AJC938/AI-PCB-Engineer/hardware/sandbox/README.md

# Sandbox

Throwaway KiCad projects used to test MCP tools and automation. Nothing here is a
deliverable, and the contents (other than this file) are gitignored. Never copy a
real design here for experiments — copy sandbox results into `hardware/kicad/`
only after review.
