AJC938/AI-PCB-Engineer/docs/visual-review/VISUAL_REVIEW.md

# Visual Review — Rev A

The generated renders below were produced from the Rev A design files using KiCad 10.0.8 command-line exports. The separate `images/screenshots/` gallery contains seven **actual GUI screenshots** captured from the released project in KiCad Schematic Editor, PCB Editor, and 3D Viewer.

No photograph exists because no board has been manufactured. 3D component bodies are KiCad library models and **represent shape only, not the exact purchased parts**. For example, LED2 is green in the BOM but uses the generic red LED model.

## Actual KiCad GUI screenshots

| Schematic | Power | PCB top | PCB bottom |
|---|---|---|---|
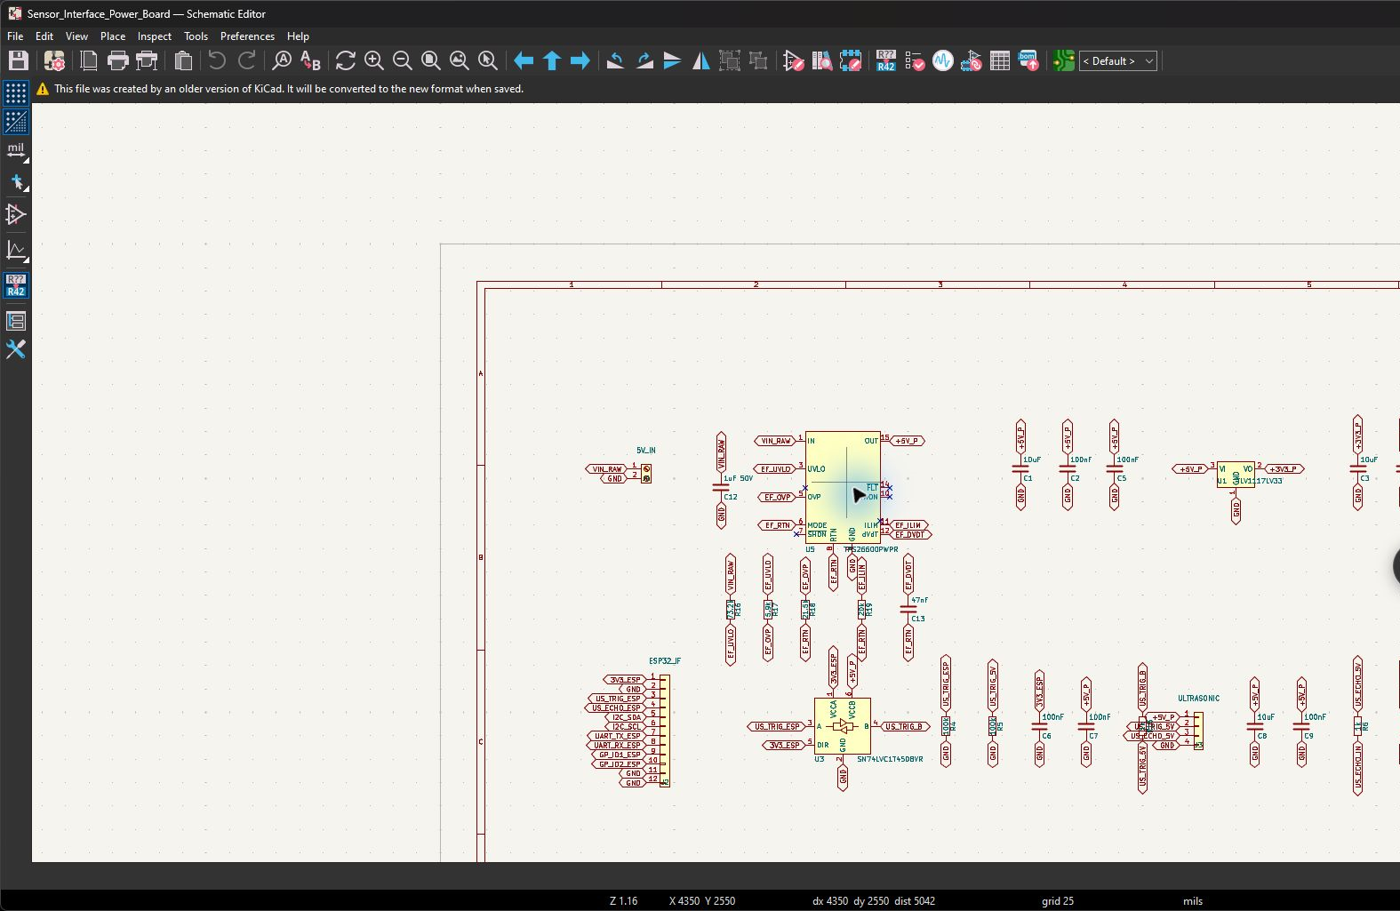
[picture p8: docs/visual-review/images/screenshots/02-power-management.png]
Power management
| Full schematic |  | PCB top | PCB bottom |

| 3D top | 3D bottom | Connector details |
|---|---|---|
| 3D top | 3D bottom | Connectors |
## 3D
| Isometric | Isometric (rear) |
|---|---|
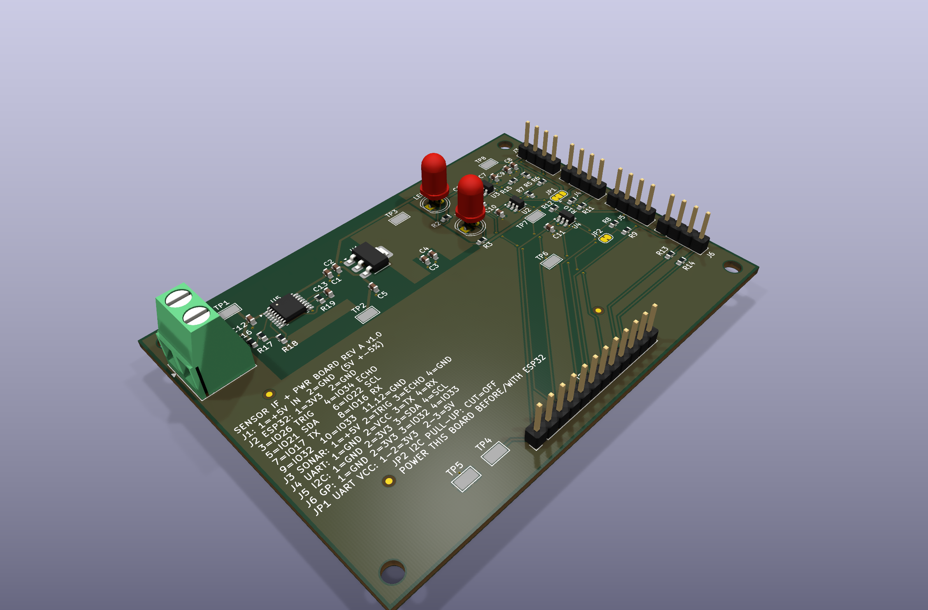
[picture p9: media/renders/3d_isometric.png]
3D isometric
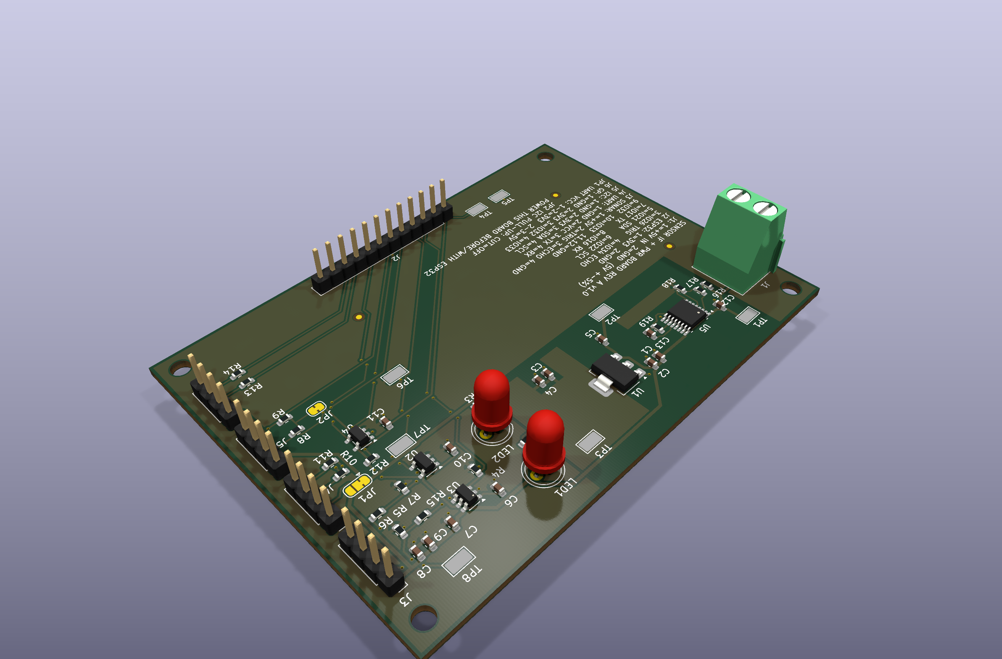
[picture p10: media/renders/3d_isometric_rear.png]
3D isometric rear
|  |  |

| Top | Bottom |
|---|---|
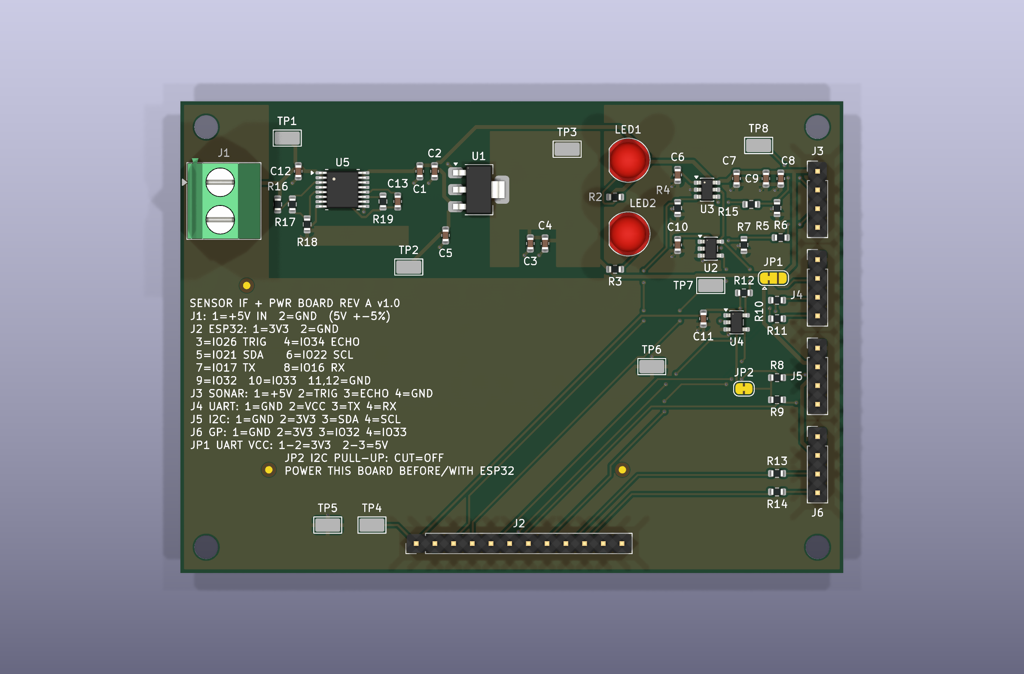
[picture p11: media/renders/3d_top.png]
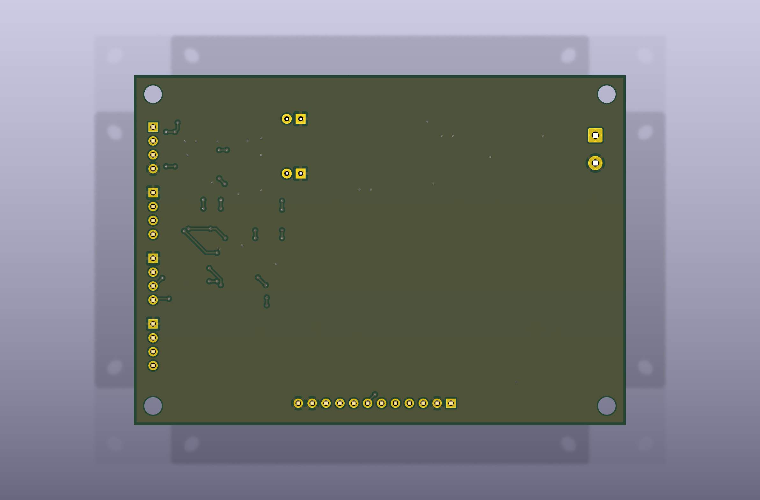
[picture p12: media/renders/3d_bottom.png]
3D bottom
|  |  |

## 2D PCB
Top (copper, mask, silkscreen, outline):

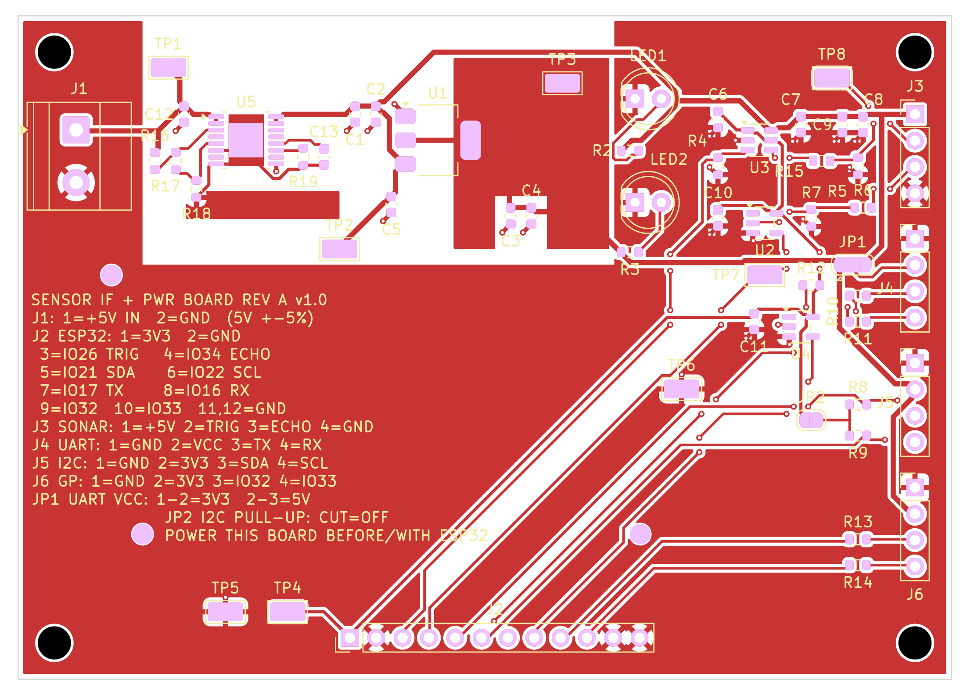
[picture p13: media/renders/pcb_top_2d.png]


Bottom (copper, mirrored, as seen from below):

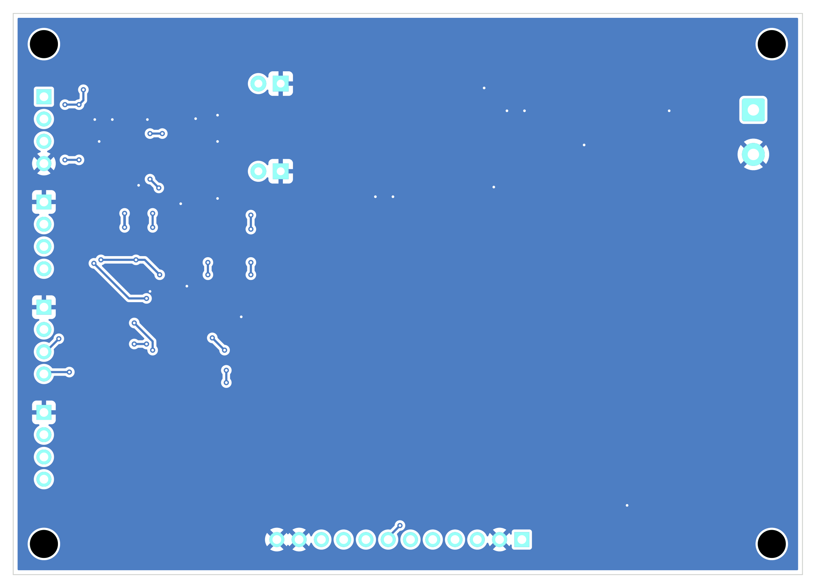
[picture p14: media/renders/pcb_bottom_2d.png]
PCB bottom


## Connector close-ups (from the top plot)
| Power input: J1, U5 eFuse, U1 LDO | Peripheral headers J3–J6 |
|---|---|
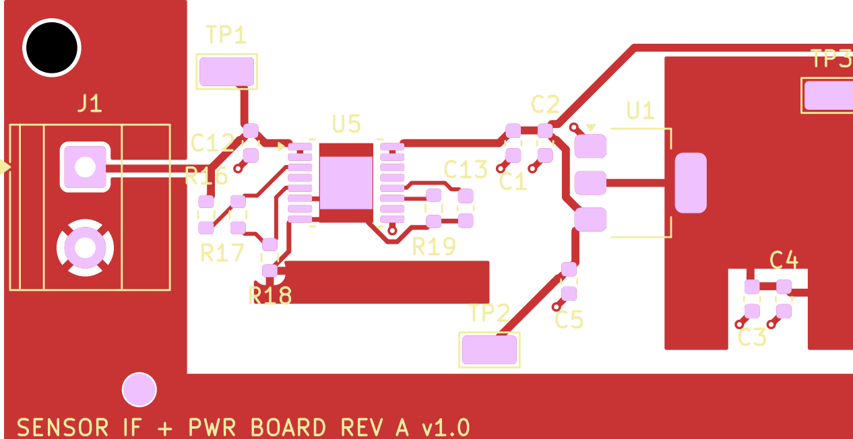
[picture p15: media/renders/closeup_power_input_J1_U5_U1.png]
power
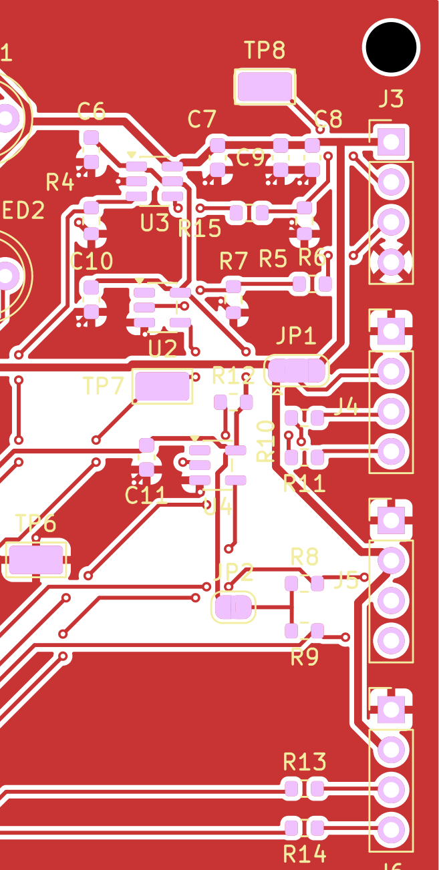
[picture p16: media/renders/closeup_peripheral_headers_J3-J6.png]
headers
|  |  |

ESP32 interface J2:

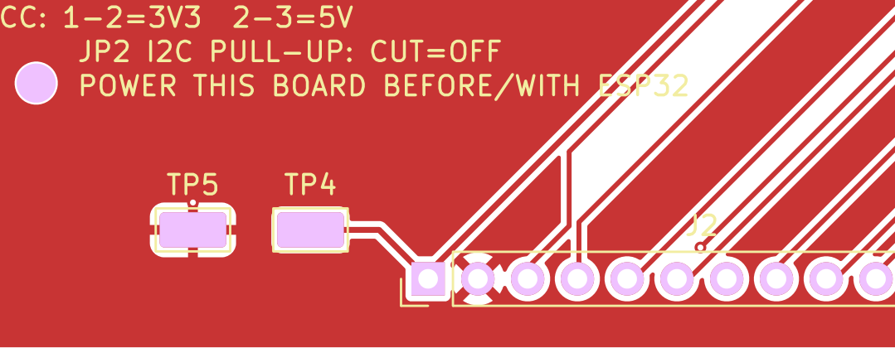
[picture p17: media/renders/closeup_esp32_header_J2.png]
J2


## Schematic
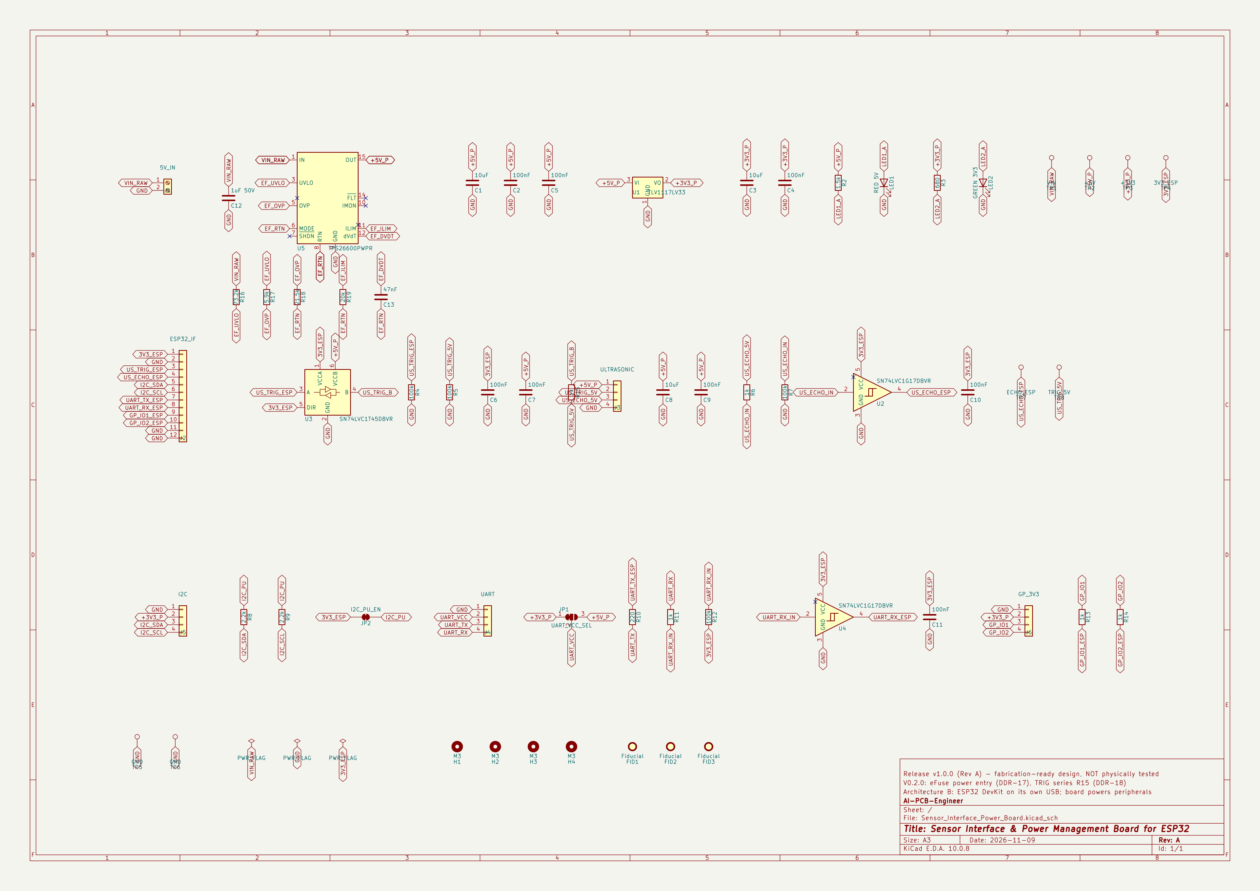
[picture p18: media/renders/schematic_overview.png]
Schematic overview


Power entry (J1, U5 eFuse, divider, RILIM, dVdT):

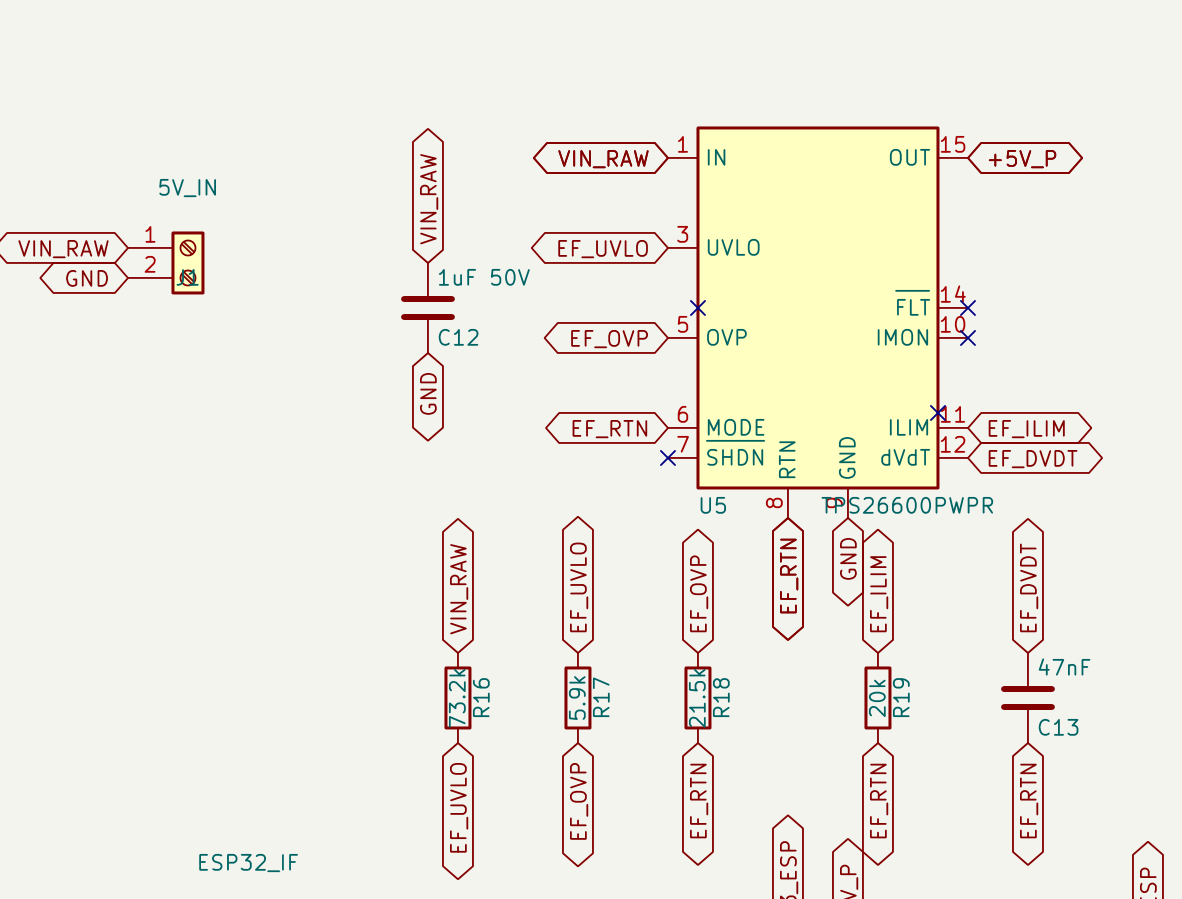
[picture p19: media/renders/schematic_power_entry_efuse.png]
eFuse


## Diagrams
Power-architecture and signal-conditioning diagrams are drawn in Mermaid (rendered by GitHub) in
[BOARD_ARCHITECTURE.md](../system-architecture/BOARD_ARCHITECTURE.md) and
[CONNECTION_GUIDE.md](../pinout/CONNECTION_GUIDE.md). They are based on the netlist.

## Owner review checklist
- [x] Actual GUI captures reviewed for board outline, connector positions and silkscreen legibility
- [x] Silkscreen label shows "REV A v1.0"
- [x] No image contains personal information
