AJC938/AI-PCB-Engineer/reports/v0.3.0/FINAL_V0.3.0_REPORT.md

# Final Report — V0.3.0: Final Engineering Audit, Open Hardware Packaging & GitHub Preparation

2026-11-09 · branch `release/v0.3.0-finalization` (from V0.2.0 `d859317`) · release **v1.0.0, board Rev A**

> **Superseded licence note (added 2026-11-09 for v1.0.0):** this report was written before the licence decision.
> The final release uses **CERN-OHL-P-2.0** for hardware and **MIT** for code (`LICENSE_SCOPE.md`,
> `reports/v1.0.0/LICENSE_AND_RELEASE_AUDIT.md`). The CERN-OHL-S-2.0 mentions below describe the release candidate only.

## 1. Status
**V0.3.0: COMPLETE (digital scope).** The release candidate `v1.0.0-rc1` is tagged locally. The stable tag
`v1.0.0` waits on one owner decision, the licence variant (CERN-OHL-S-2.0 prepared). It is a licensing choice
with different redistribution consequences, so it is not made on the owner's behalf.
**Physical status: NOT FABRICATED, NOT PHYSICALLY TESTED.** No push, upload, order, purchase or account.

## 2. Final design
90.0 × 64.0 mm, 2 layers, FR-4 1.6 mm, 1 oz, top-side assembly (44 SMT + 8 THT), Rev A. TPS26600 eFuse input
(OVP / UVLO / reverse / current limit), TLV1117LV33 3.3 V peripheral LDO, SN74LVC1T45 + SN74LVC1G17 ultrasonic
conditioning, I²C / UART / GPIO headers. Architecture B: the ESP32 DevKit stays on its own USB, and 3V3_ESP is
used only as a logic reference.

## 3. Engineering audit (`FINAL_ENGINEERING_AUDIT.md`)
- **TPS26600:** every pin checked against SLVSDG2G Rev. G: PASS. MODE→RTN = current limit with auto-retry.
  PowerPAD on an isolated RTN island: PASS. Accepted deviation: no RTN vias (19 mW normal dissipation).
- **Reverse polarity:** every conductive path traced. Protected for floating sources. **Not protected** when an
  earthed supply negative and an earthed USB host or peripheral form a loop through the common GND. Classified as
  inherent; documented with a procedural mitigation (L-1).
- **Thermal:** 251.2 mm² solid +3V3_P copper confirmed by board read-back → Tj ≈ 94.7 °C at 50 °C (CALCULATED).
  New published rating: 250 mA at ≤ 50 °C.
- **Signals, power domains, connectors:** PASS. J6 and the J2 signals are 3.3 V only (documented).
- **Footprints/mechanics:** 61 footprints reviewed. No absolute paths. KiCad 10 required. Mating housings,
  sensor pin order and enclosure are not verified.
- **Correction needed:** none electrical. DDR-22 sets the revision label to Rev A (silkscreen and title block only).

## 4. Manufacturing package (`manufacturing/Sensor_Interface_Power_Board/RevA/`)
Regenerated by `scripts/release/build_release.sh` and audited 19/19 PASS. Fabrication, Assembly and Complete
ZIPs: extraction-tested, byte-compared and privacy-scanned. `SHA256SUMS.txt` 28/28 OK. The BOM (33 lines /
52 parts) now has engineering descriptions, dated sourcing notes and verified alternatives. Copper, drill, CPL and
IPC-D-356 are identical to V0.2.0.

**Sourcing (2026-11-09):** TPS26600PWPR is ACTIVE. TI store out of stock. DigiKey 0 in stock, 2,000 expected on
2026-12-14, 26-week lead time. LCSC listing exists, stock not readable. This is a commercial risk and does not
block the design release.

## 5. GitHub preparation
- Hardware README (23 sections).
- `docs/` tree: quick start, architecture, electrical, pinout/connection guide, layout, manufacturing, assembly,
  safety, validation, visual review, licensing, AI workflow.
- `LICENSE-HARDWARE` (CERN-OHL-S-2.0, official SPDX text) and `LICENSE-CODE` (MIT).
- `CONTRIBUTING.md`, release notes and checklist in `release/v1.0.0/`.
- KiCad renders in `media/renders/`.
- `.gitattributes` keeps the release files byte-exact.

## 6. Validation (final run)
| Check | Result |
|---|---|
| ERC (all severities) | 0 |
| DRC (all severities, zones refilled / stored) | 0 errors, 0 warnings / same |
| Unconnected | 0 |
| Schematic parity | 0 |
| Netlist + power-domain verifier | PASS |
| Manufacturing audit | 19/19 PASS |
| ZIP tests / checksums | PASS / 28/28 |
| Fresh-process reopen (MCP SWIG) | 7/7, design files unchanged |
| Relative links in Markdown | 0 broken |

## 7. Remaining limitations
L-1 ground-loop reverse polarity · L-2 no surge or fast-OVP coverage · L-3 +3V3_P 250 mA thermal rating
(calculated) · L-4 sequencing rule R-31 · L-5 sensor pin order, mating connectors and enclosure unverified ·
L-6 TPS26600PWPR stock · L-7 not fabricated or tested.

## 8. Owner actions
1. Confirm the licence variant. Then create the local `v1.0.0` tag on the release commit.
2. Review the renders (`docs/visual-review/VISUAL_REVIEW.md`).
3. Publish manually on GitHub (`release/v1.0.0/RELEASE_CHECKLIST.md` §C).
4. Ordering is a separate decision: supplier choice and quote with THT method and TPS26600PWPR availability.
