AJC938/AI-PCB-Engineer/reports/v0.2.0/3D_REVIEW.md

# 3D Review — V0.2.0

Renders: `kicad-cli pcb render`, high quality, KiCad 10.0.8 library 3D models
(`evidence/images/3d_top.png`, `3d_bottom.png`, `3d_iso.png`, `3d_left.png`). STEP:
`manufacturing/v0.2.0/3d/…step`. **These are visual and mechanical review aids, not physical proof.**

| Check | Observation | Status |
|---|---|---|
| All components present | 52 assembled parts visible on top; bottom shows only THT pins and the GND plane | PASS |
| Overlaps | none between bodies (also courtyard DRC 0) | PASS |
| J1 terminal block | wire entries face the **left board edge** (left view). Screws accessible from the top. Body inside the outline | PASS |
| Connectors J2–J6 | male vertical pins at the edges. 1.84 mm between mating housings on the right edge; J2 cable exits the bottom edge; no tall part in front of any connector | PASS |
| Board edges / holes | 4 × M3 holes clear of parts (keep-out radius 3.45 mm); nothing overhangs | PASS |
| Component height | tallest: LED1/LED2 (5 mm T-1¾ body) and the header pins; the terminal block is next. No height limit was specified | INFO |
| Polarity | LED flats/square pads, IC pin-1 marks and connector pin-1 marks visible on silk | PASS |
| THT protrusion | header and LED leads protrude on the bottom only. No bottom components, so no conflict with standoffs (M3) | PASS |
| Cable clearance | right-edge connectors leave ≥ 1.8 mm between housings for 4-pin female Dupont housings; J1 entry unobstructed | PASS (by geometry; not test-fitted) |
| Model fidelity | LED2 uses the generic red 5 mm model (green part); header models are generic 2.54 mm. No vendor STEP models were downloaded | LIMITATION |

Not claimed: exact mechanical compatibility with a specific enclosure or with the DevKit clone (no verified
drawing; Option B cable interface).
