AJC938/AI-PCB-Engineer/reports/v0.2.0/V0.2.0_COMPLETION_SUMMARY.md

# V0.2.0 Completion Summary

| # | Completion criterion (prompt §21) | Status | Evidence |
|---|---|---|---|
| 1 | Electrical design review complete | PASS | ELECTRICAL_DESIGN_REVIEW.md |
| 2 | TVS/LDO compatibility resolved | PASS (design; NOT TESTED) | TVS_LDO_PROTECTION_ANALYSIS.md |
| 3 | Power-domain integrity verified | PASS (netlist rules, parity 0) | verify_output.txt, DRC parity |
| 4 | LDO thermal layout justified | PASS (CALCULATED, 251 mm²) | POWER_AND_THERMAL_REVIEW.md |
| 5 | Footprints independently checked | PASS (IPC-7351 alternatives noted) | FOOTPRINT_VERIFICATION.md |
| 6 | Manufacturer research complete | PASS (4 vendors, official pages) | MANUFACTURER_COMPARISON.md |
| 7 | Suitable full-turnkey SMT/THT manufacturer identified | **PROVISIONAL**: PCBWay recommended; owner approval and THT-method/stock confirmation pending | MANUFACTURER_SELECTION_RECOMMENDATION.md |
| 8 | BOM sourcing evaluated | PASS (with risk R-36: TPS26600 stock) | BOM_SOURCING_AUDIT.md |
| 9 | Board outline defined | PASS 90 × 64 mm | PCB_PLACEMENT_REVIEW.md |
| 10 | All components placed | PASS 61/61 | pcb_extract (placement vs plan) |
| 11 | All required nets routed | PASS 0 unconnected | DRC_VALIDATION.md |
| 12 | Copper zones refilled | PASS (stored and refilled DRC identical) | DRC_VALIDATION.md |
| 13 | ERC reviewed | PASS 0 | ERC_VALIDATION.md |
| 14 | DRC reviewed independently | PASS 0 / 0 / 0, no exclusions | DRC_VALIDATION.md |
| 15 | Schematic parity checked | PASS 0 | DRC_VALIDATION.md |
| 16 | 3D review complete | PASS (review aid) | 3D_REVIEW.md |
| 17 | DFM complete | PASS (generic profile; vendor DFM pending) | DFM_REPORT.md |
| 18 | DFA complete | PASS (vendor THT method pending) | DFA_REPORT.md |
| 19 | Gerber and drill outputs verified | PASS 11/11 | MANUFACTURING_FILES_AUDIT.md |
| 20 | BOM and CPL verified | PASS | ASSEMBLY_PACKAGE_AUDIT.md |
| 21 | Assembly drawings ready | PASS | manufacturing/v0.2.0/assembly/ |
| 22 | Open issues recorded | PASS | OPEN_QUESTIONS.md |
| 23 | Project reopens successfully | PASS (fresh MCP process + pcbnew + kicad-cli) | mcp_runs/run_p7_reopen.json |
| 24 | Git state clean and documented | PASS (at final commit) | FINAL_V0.2.0_REPORT.md §Git |

**Digital design status: COMPLETE.** **Supplier approval: PENDING (owner).** **Physical status: NOT FABRICATED,
NOT TESTED.** Per §20/§21 no stable `v0.2.0` tag was created, because supplier approval is outstanding
(criterion 7 is provisional).
