AJC938/AI-PCB-Engineer/reports/v0.1.0/PHASE_COMPLETION_SUMMARY.md

# Phase Completion Summary — V0.1.0

| Scope item | Result | Document |
|---|---|---|
| Repository and Phase 1 review | Done. Phase 1 baseline kept. Status notes and risks appended | `docs/requirements/v0.1.0/` |
| ESP32 platform / GPIO map | DevKitC V4 (WROOM-32) reference. Safe GPIO map | SYSTEM_ARCHITECTURE.md, DDR-13 |
| Mechanical options A vs B | B (cable) chosen. A deferred, with no invented dimensions | SYSTEM_ARCHITECTURE.md, DDR-14 |
| Ultrasonic module + level translation | Adafruit 4007. LVC1T45 TRIG, LVC1G17 ECHO | SIGNAL_COMPATIBILITY.md |
| Power architecture A vs B | B selected | POWER_ARCHITECTURE.md |
| Power budget per rail | Done (min/nom/max, dissipation, thermal) | POWER_BUDGET_FINAL.md |
| I2C / UART specification | Done | SIGNAL_COMPATIBILITY.md |
| MPNs + datasheets | 48 parts. DS-01…16 official sources | COMPONENT_SELECTION.md, DATASHEET_VERIFICATION.md |
| Calculations + independent checks | PASS (10/10 Monte Carlo) | `calculations/v0.1.0/` |
| Complete KiCad schematic (MCP) | Done, A3, 50 parts | SCHEMATIC_DESIGN_REVIEW.md |
| ERC / netlist / domains / footprints / CLI / reopen | All PASS. ERC 0, no exclusions | ERC_VALIDATION.md |
| Open questions | Resolution register. 2 owner decisions + physical checks remain | OPEN_QUESTIONS.md |
| Decisions | DDR-01…16 | DESIGN_DECISION_RECORD.md |
| Evidence | E-01…E-30 | EVIDENCE_INDEX.md |
| Final report | — | FINAL_V0.1.0_DESIGN_REPORT.md |

## MCP observations from this milestone
- The SWIG backend handled 326 schematic calls with no failures. Pin-snapped global labels gave exact connectivity.
- **New limitation:** there is no MCP tool for paper size or title block. A controlled script was used, then validated.
- `search_symbols` was not needed (known D-13). Symbols were taken from known library names and checked with
  `batch_list_symbol_pins`.

## Not done (out of scope or needs a human)
PCB layout, DRC, fabrication outputs, purchases, orders, physical tests, stable tag, push.

**Overall: V0.1.0 COMPLETE (design + schematic). Next: V0.2.0 PCB layout, after OQ-16.**
