AJC938/AI-PCB-Engineer/reports/v0.3.0/EVIDENCE_INDEX.md

# Evidence Index — V0.3.0

Paths are relative to the repository root. Machine paths in tool output were replaced with `<repo>` / `<home>`.

| ID | Item | Path | Label |
|---|---|---|---|
| E3-01 | Final engineering audit | `reports/v0.3.0/FINAL_ENGINEERING_AUDIT.md` | VERIFIED (datasheet, board read-back) / CALCULATED |
| E3-02 | Audit calculations (LDO rating, fault cases, reverse-polarity paths) + output | `calculations/v0.3.0/release_audit_calcs.py`, `_output.txt` | CALCULATED |
| E3-03 | BOM sourcing audit (2026-11-09) | `reports/v0.3.0/BOM_SOURCING_AUDIT.md`, `scripts/release/bom_enrichment.csv` | VERIFIED (distributor/TI pages) / NOT VERIFIED marked |
| E3-04 | ERC (json + report) | `evidence/validation/erc.json`, `erc.rpt` | TOOL-CHECKED: 0 |
| E3-05 | Netlist + verifier | `evidence/validation/netlist.xml`, `verify_schematic.txt` | TOOL-CHECKED: PASS |
| E3-06 | DRC refilled (json + report) and stored zones | `evidence/validation/drc_refilled.json`, `.rpt`, `drc_stored_zones.json` | TOOL-CHECKED: 0/0/0 |
| E3-07 | Release package audit | `evidence/validation/release_audit.txt` | TOOL-CHECKED: 19/19 |
| E3-08 | Fresh-process MCP reopen | `evidence/mcp_runs/run_v030_reopen.json` | TOOL-CHECKED: 7/7 |
| E3-09 | Package audit, ZIP tests, checksums | `reports/v0.3.0/MANUFACTURING_PACKAGE_AUDIT.md`, `manufacturing/Sensor_Interface_Power_Board/RevA/checksums/SHA256SUMS.txt` | TOOL-CHECKED |
| E3-10 | Repository audit | `reports/v0.3.0/REPOSITORY_RELEASE_AUDIT.md` | TOOL-CHECKED |
| E3-11 | Renders and plots | `media/renders/*.png` | generated by KiCad |
| E3-12 | Release scripts (reproducible) | `scripts/release/*.py`, `build_release.sh` | — |
| E3-13 | Physical evidence | `testing/` | **none: NOT TESTED** |
