AJC938/AI-PCB-Engineer/manufacturing/Sensor_Interface_Power_Board/RevA/assembly/Sensor_Interface_Power_Board_RevA_BOM.csv

Item | Qty | References | Value | Description | Manufacturer | MPN | Package | Mount | Side | DNP | Sourcing notes (checked 2026-11-09) | Verified alternative | Substitution
1 | 3 | C1 C3 C8 | 10uF | MLCC 10 uF +-10 % 10 V X5R, 0603 | Samsung Electro-Mechanics | CL10A106KP8NNNC | C_0603_1608Metric | SMT | Top | No | Multi-source high-volume part; stock not verified | None verified (any change needs approval) | NO SUBSTITUTION without written approval
2 | 8 | C2 C4 C5 C6 C7 C9 C10 C11 | 100nF | MLCC 100 nF +-10 % 16 V X7R, 0603 | Murata | GRM188R71C104KA01D | C_0603_1608Metric | SMT | Top | No | Multi-source high-volume part; stock not verified | None verified (any change needs approval) | NO SUBSTITUTION without written approval
3 | 1 | C12 | 1uF 50V | MLCC 1.0 uF +-10 % 50 V X5R, 0603 (eFuse input, 50 V rating required) | Samsung Electro-Mechanics | CL10A105KB8NNNC | C_0603_1608Metric | SMT | Top | No | Samsung spec page read 2026-11-09; stock not verified | None verified (must stay >= 50 V) | NO SUBSTITUTION without written approval
4 | 1 | C13 | 47nF | MLCC 47 nF +-10 % 50 V X7R, 0603 (eFuse dVdT) | Samsung Electro-Mechanics | CL10B473KB8NNNC | C_0603_1608Metric | SMT | Top | No | Samsung spec page read 2026-11-09; stock not verified | None verified (any change needs approval) | NO SUBSTITUTION without written approval
5 | 1 | J1 | 5V_IN | PCB terminal block MKDS 1,5/2-5,08, 2 positions, 5.08 mm pitch, screw, THT | Phoenix Contact | 1715721 | TerminalBlock_Phoenix_MKDS-1,5-2-5.08_1x02_P5.08mm_Horizontal | THT | Top | No | Phoenix page not readable from research network; stock not verified | None verified | NO SUBSTITUTION without written approval
6 | 1 | J2 | ESP32_IF | Pin header 1x12, 2.54 mm, tin, THT, vertical, lead-free process | Samtec | HTSW-112-07-T-S | PinHeader_1x12_P2.54mm_Vertical | THT | Top | No | Samtec page not readable for this length; stock not verified | None verified | NO SUBSTITUTION without written approval
7 | 1 | J3 | ULTRASONIC | Pin header 1x4, 2.54 mm, tin, THT, vertical, lead-free process | Samtec | HTSW-104-07-T-S | PinHeader_1x04_P2.54mm_Vertical | THT | Top | No | samtec.com 2026-11-09: "Ships Tomorrow: 3268 pieces" | None verified | NO SUBSTITUTION without written approval
8 | 1 | J4 | UART | Pin header 1x4, 2.54 mm, tin, THT, vertical, lead-free process | Samtec | HTSW-104-07-T-S | PinHeader_1x04_P2.54mm_Vertical | THT | Top | No | samtec.com 2026-11-09: "Ships Tomorrow: 3268 pieces" | None verified | NO SUBSTITUTION without written approval
9 | 1 | J5 | I2C | Pin header 1x4, 2.54 mm, tin, THT, vertical, lead-free process | Samtec | HTSW-104-07-T-S | PinHeader_1x04_P2.54mm_Vertical | THT | Top | No | samtec.com 2026-11-09: "Ships Tomorrow: 3268 pieces" | None verified | NO SUBSTITUTION without written approval
10 | 1 | J6 | GP_3V3 | Pin header 1x4, 2.54 mm, tin, THT, vertical, lead-free process | Samtec | HTSW-104-07-T-S | PinHeader_1x04_P2.54mm_Vertical | THT | Top | No | samtec.com 2026-11-09: "Ships Tomorrow: 3268 pieces" | None verified | NO SUBSTITUTION without written approval
11 | 1 | LED1 | RED 5V | LED 5 mm red, THT (+5V_P indicator) | Kingbright | WP7113ID | LED_D5.0mm | THT | Top | No | Stock not verified | None verified | NO SUBSTITUTION without written approval
12 | 1 | LED2 | GREEN 3V3 | LED 5 mm green, THT (+3V3_P indicator) | Kingbright | WP7113SGD | LED_D5.0mm | THT | Top | No | Stock not verified | None verified | NO SUBSTITUTION without written approval
13 | 1 | R2 | 1.5k | Resistor 1.5 kOhm +-1 % 0.1 W thick film, 0603 | Panasonic | ERJ-3EKF1501V | R_0603_1608Metric | SMT | Top | No | Multi-source high-volume family; stock not verified | None verified (1 % 0603 same value needs approval) | NO SUBSTITUTION without written approval
14 | 1 | R3 | 680 | Resistor 680 Ohm +-1 % 0.1 W thick film, 0603 | Panasonic | ERJ-3EKF6800V | R_0603_1608Metric | SMT | Top | No | Multi-source high-volume family; stock not verified | None verified (1 % 0603 same value needs approval) | NO SUBSTITUTION without written approval
15 | 4 | R4 R5 R7 R12 | 100k | Resistor 100 kOhm +-1 % 0.1 W thick film, 0603 | Panasonic | ERJ-3EKF1003V | R_0603_1608Metric | SMT | Top | No | Multi-source high-volume family; stock not verified | None verified (1 % 0603 same value needs approval) | NO SUBSTITUTION without written approval
16 | 5 | R6 R11 R13 R14 R15 | 1k | Resistor 1 kOhm +-1 % 0.1 W thick film, 0603 | Panasonic | ERJ-3EKF1001V | R_0603_1608Metric | SMT | Top | No | Multi-source high-volume family; stock not verified | None verified (1 % 0603 same value needs approval) | NO SUBSTITUTION without written approval
17 | 2 | R8 R9 | 2.2k | Resistor 2.2 kOhm +-1 % 0.1 W thick film, 0603 | Panasonic | ERJ-3EKF2201V | R_0603_1608Metric | SMT | Top | No | Multi-source high-volume family; stock not verified | None verified (1 % 0603 same value needs approval) | NO SUBSTITUTION without written approval
18 | 1 | R10 | 220 | Resistor 220 Ohm +-1 % 0.1 W thick film, 0603 | Panasonic | ERJ-3EKF2200V | R_0603_1608Metric | SMT | Top | No | Multi-source high-volume family; stock not verified | None verified (1 % 0603 same value needs approval) | NO SUBSTITUTION without written approval
19 | 1 | R16 | 73.2k | Resistor 73.2 kOhm +-1 % 0.1 W thick film, 0603 (eFuse UVLO/OVP divider, 1 % required) | Panasonic | ERJ-3EKF7322V | R_0603_1608Metric | SMT | Top | No | Multi-source high-volume family; stock not verified | None verified (1 % or better required) | NO SUBSTITUTION without written approval
20 | 1 | R17 | 5.9k | Resistor 5.9 kOhm +-1 % 0.1 W thick film, 0603 (eFuse UVLO/OVP divider, 1 % required) | Panasonic | ERJ-3EKF5901V | R_0603_1608Metric | SMT | Top | No | Multi-source high-volume family; stock not verified | None verified (1 % or better required) | NO SUBSTITUTION without written approval
21 | 1 | R18 | 21.5k | Resistor 21.5 kOhm +-1 % 0.1 W thick film, 0603 (eFuse UVLO/OVP divider, 1 % required) | Panasonic | ERJ-3EKF2152V | R_0603_1608Metric | SMT | Top | No | Multi-source high-volume family; stock not verified | None verified (1 % or better required) | NO SUBSTITUTION without written approval
22 | 1 | R19 | 20k | Resistor 20 kOhm +-1 % 0.1 W thick film, 0603 (eFuse current limit, 1 % required) | Panasonic | ERJ-3EKF2002V | R_0603_1608Metric | SMT | Top | No | Multi-source high-volume family; stock not verified | None verified (1 % or better required) | NO SUBSTITUTION without written approval
23 | 1 | TP1 | VIN | Test point, SMT, micro-mini | Keystone Electronics | 5015 | TestPoint_Keystone_5015_Micro_Mini | SMT | Top | No | Keystone page not readable from research network; stock not verified | None verified | NO SUBSTITUTION without written approval
24 | 1 | TP2 | +5V | Test point, SMT, micro-mini | Keystone Electronics | 5015 | TestPoint_Keystone_5015_Micro_Mini | SMT | Top | No | Keystone page not readable from research network; stock not verified | None verified | NO SUBSTITUTION without written approval
25 | 1 | TP3 | +3V3 | Test point, SMT, micro-mini | Keystone Electronics | 5015 | TestPoint_Keystone_5015_Micro_Mini | SMT | Top | No | Keystone page not readable from research network; stock not verified | None verified | NO SUBSTITUTION without written approval
26 | 1 | TP4 | 3V3_ESP | Test point, SMT, micro-mini | Keystone Electronics | 5015 | TestPoint_Keystone_5015_Micro_Mini | SMT | Top | No | Keystone page not readable from research network; stock not verified | None verified | NO SUBSTITUTION without written approval
27 | 2 | TP5 TP6 | GND | Test point, SMT, micro-mini | Keystone Electronics | 5015 | TestPoint_Keystone_5015_Micro_Mini | SMT | Top | No | Keystone page not readable from research network; stock not verified | None verified | NO SUBSTITUTION without written approval
28 | 1 | TP7 | ECHO_ESP | Test point, SMT, micro-mini | Keystone Electronics | 5015 | TestPoint_Keystone_5015_Micro_Mini | SMT | Top | No | Keystone page not readable from research network; stock not verified | None verified | NO SUBSTITUTION without written approval
29 | 1 | TP8 | TRIG_5V | Test point, SMT, micro-mini | Keystone Electronics | 5015 | TestPoint_Keystone_5015_Micro_Mini | SMT | Top | No | Keystone page not readable from research network; stock not verified | None verified | NO SUBSTITUTION without written approval
30 | 1 | U1 | TLV1117LV33 | LDO regulator 3.3 V 1 A, SOT-223 (DCY) | Texas Instruments | TLV1117LV33DCYR | SOT-223-3_TabPin2 | SMT | Top | No | TI addendum: Active / Production; stock not verified | None verified (no DCYT variant in TI addendum) | NO SUBSTITUTION without written approval
31 | 2 | U2 U4 | SN74LVC1G17DBVR | Single Schmitt-trigger buffer, SOT-23-5 (DBV) | Texas Instruments | SN74LVC1G17DBVR | SOT-23-5 | SMT | Top | No | TI addendum: Active / Production; stock not verified | SN74LVC1G17DBVT (same device; 250-pc reel; TI addendum Active) | NO SUBSTITUTION without written approval
32 | 1 | U3 | SN74LVC1T45DBVR | Single-bit dual-supply level translator, SOT-23-6 (DBV) | Texas Instruments | SN74LVC1T45DBVR | SOT-23-6 | SMT | Top | No | TI store: ACTIVE but out of stock (2026-11-09). Distributor search snapshots show stock (undated; not verified) | SN74LVC1T45DBVT (same device; 250-pc reel; TI addendum Active) | NO SUBSTITUTION without written approval
33 | 1 | U5 | TPS26600PWPR | eFuse 60 V 2 A, reverse polarity protection, adjustable OVP/UVLO/current limit, HTSSOP-16 PowerPAD (PWP) | Texas Instruments | TPS26600PWPR | TI_PWP0016A_HTSSOP-16-1EP_4.4x5mm_P0.65mm_EP3.4x5mm | SMT | Top | No | HIGH RISK. TI store: ACTIVE, out of stock (2026-11-09). DigiKey 6199305: 0 in stock, 2,000 expected 2026-12-14, 26-week standard lead time (page read 2026-11-09). LCSC C544399 listed, stock not readable. Confirm in the quote or consign | TPS26600PWPT (same device; 250-pc reel; also out of stock at TI 2026-11-09) | NO SUBSTITUTION without written approval
