AJC938/AI-PCB-Engineer/manufacturing/Sensor_Interface_Power_Board/RevA/3d/Sensor_Interface_Power_Board_RevA.step

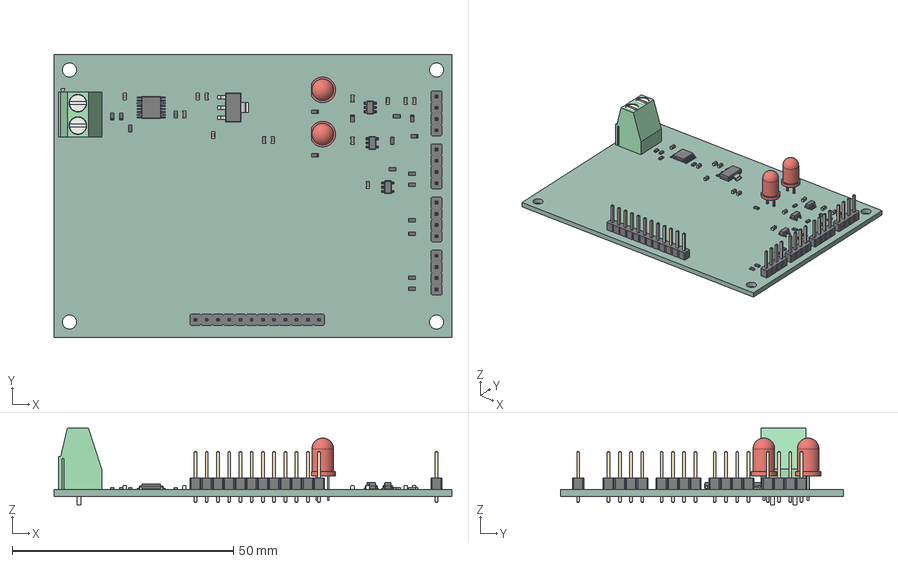
[picture p20: CAD file, 2026-11-09]
manufacturing/Sensor_Interface_Power_Board/RevA/3d/Sensor_Interface_Power_Board_RevA.step
90.0 x 64.0 x 17.3 mm
R_0603_1608Metric x 18
C_0603_1608Metric x 13
SOT-23-5 x 2
SOT-223
PinHeader_1x12_P254mm_Vertical
PinHeader_1x04_P254mm_Vertical x 4
SOT-23-6
TerminalBlock_Phoenix_MKDS-1,5-2-5.08_1x02_P5.08mm_Horizontal
LED_D5.0mm x 2
HTSSOP-16-1EP_4.4x5mm_P0.65mm_EP3.4x5mm_Mask2.66x2.46mm
Sensor_Interface_Power_Board_PCB
