AJC938/AI-PCB-Engineer/(list of files, cad)

Other CAD files:
manufacturing/v0.2.0/3d/Sensor_Interface_Power_Board_v0.2.0.step
