AJC938/AI-PCB-Engineer/manufacturing/README.md

# Manufacturing

| Folder | Status |
|---|---|
| [Sensor_Interface_Power_Board/](Sensor_Interface_Power_Board/) | **Current release: Rev A (v1.0.0)**, packages, checksums, manufacturer profiles |
| [v0.2.0/](v0.2.0/) | Historical V0.2.0 package (board rev 0.2.0). Kept unchanged for traceability; do not use for new orders |

Released revisions are never overwritten. A design change creates a new revision folder (Rev B, …).
