AJC938/AI-PCB-Engineer/manufacturing/Sensor_Interface_Power_Board/README.md

# Sensor Interface & Power Management Board — Manufacturing

| Revision | Release | Status | Folder |
|---|---|---|---|
| **A** | v1.0.0 (2026-11-09) | Fabrication-ready digital design; **NOT fabricated or tested** | [RevA/](RevA/) |

[`manufacturer-profiles/`](manufacturer-profiles/): researched suppliers. **None is confirmed**; the standard
package works with any qualified manufacturer.
