AJC938/AI-PCB-Engineer/manufacturing/v0.2.0/README.md

# Manufacturing package — Rev 0.2.0

Sensor Interface & Power Management Board for ESP32. Generated 2026-11-09 from
`hardware/kicad/Sensor_Interface_Power_Board/` with KiCad 10.0.8 (kicad-cli). **Not submitted anywhere.**

| Folder | Content |
|---|---|
| `gerbers/` | Gerber X2 (9 layers incl. empty B.Paste/B.Silkscreen), job file, Excellon PTH/NPTH + drill maps, IPC-D-356 |
| `assembly/` | BOM, CPL, assembly drawings (top, bottom), layer plots, schematic PDF |
| `3d/` | STEP model (mechanical review aid, not a measured model) |
| `docs/` | FABRICATION_NOTES.md, ASSEMBLY_NOTES.md |
| `manufacturer_profiles/` | Generic DFM profile (applied), PCBWay provisional, NextPCB alternate |

Audit: `hardware/kicad/Sensor_Interface_Power_Board/build/audit_fab_outputs.py` → 11/11 PASS
(`reports/v0.2.0/evidence/validation/fab_audit_output.txt`). Before any order the owner must approve the
manufacturer and confirm the open commercial items in `reports/v0.2.0/OPEN_QUESTIONS.md`.
