AJC938/AI-PCB-Engineer/manufacturing/Sensor_Interface_Power_Board/manufacturer-profiles/NEXTPCB_PROFILE.md

# NextPCB — candidate profile (NOT approved)

Status: **candidate / alternate** (V0.2.0 score 4.40/5). No account, upload, quote or order. Official pages read
**2026-11-09**: https://www.nextpcb.com/pcb-capabilities and https://www.nextpcb.com/pcb-assembly-services
(the assembly-capabilities page and PCBA guide could not be read from the research network).

| Capability | Published (2026-11-09) | This design |
|---|---|---|
| PCB fabrication | 2-layer FR-4 1.6 mm 1 oz listed; 3/3 mil track/space (1 oz); min drill 0.15 mm; PTH tolerance ±0.075 mm; copper to edge ≥ 0.2 mm | 0.25/0.20 mm, 0.3 mm drill, 0.5 mm edge |
| SMT / THT / mixed | yes, single/double side; wave-soldering line shown in factory photos; "Automated/Manual soldering" | top-side mixed |
| THT soldering method | wave line shown; method for this board **not confirmed** | must be confirmed |
| Full turnkey | full / partial turnkey / consigned | full turnkey |
| Customer-supplied parts | consigned option | option for U5 |
| Component sourcing | HQ Online + global distributors | exact MPNs only |
| Substitution policy | **NOT FOUND** on pages read | must be agreed in writing |
| Lead-free | lead-free RoHS | required |
| MOQ | none (from 1 pc) | — |
| DFM / DFA | free on every order | — |
| Shipping | DHL/FedEx "to 166+ countries"; Saudi Arabia **not named** on pages read | to confirm |
