AJC938/AI-PCB-Engineer/manufacturing/Sensor_Interface_Power_Board/manufacturer-profiles/OTHER_CANDIDATES.md

# Other researched candidates (NOT approved)

Official pages read **2026-11-09**. Values not found are marked so. Details and sources:
[`reports/v0.2.0/MANUFACTURER_COMPARISON.md`](../../../reports/v0.2.0/MANUFACTURER_COMPARISON.md).

| Item | Seeed Fusion (score 3.70) | Eurocircuits (score 3.45) |
|---|---|---|
| Sources read | wiki.seeedstudio.com/Service_for_Fusion_PCB, seeedstudio.com/pcb-assembly.html, /fusion_pcb.html | eurocircuits.com/services/pcb-assembly-capabilities/ |
| 2-layer FR-4 1.6 mm | yes | not retrieved (pool page refused) |
| SMT / THT | SMT, THT, mixed; single/double side | SMT/THT, single or double sided; max 800 THT placements |
| THT soldering method | NOT FOUND | NOT FOUND |
| Lead-free | NOT FOUND | SAC305 lead-free |
| Sourcing | turnkey via Open Parts Library + BOM procurement; consigned NOT FOUND | all parts sourced; customer may supply parts it cannot source |
| Substitution policy | NOT FOUND | NOT FOUND |
| Assembly quantity | from 1 pc | 1–50 pcs |
| Shipping to Saudi Arabia | NOT FOUND | NOT FOUND (EU-based) |

Either can be used with the standard package if the quote confirms the items listed in [README.md](README.md).
