AJC938/AI-PCB-Engineer/manufacturing/Sensor_Interface_Power_Board/manufacturer-profiles/PCBWAY_PROFILE.md

# PCBWay — candidate profile (NOT approved)

Status: **candidate**, recommended by the V0.2.0 weighted comparison (score 4.50/5). No account, upload, quote
or order. Facts below are from official pages read **2026-11-09**: https://www.pcbway.com/capabilities.html and
https://www.pcbway.com/assembly-capabilities.html. Shipping pages could not be read from the research network.

| Capability | Published (2026-11-09) | This design |
|---|---|---|
| PCB fabrication | 2-layer FR-4, 1.6 mm, 1 oz in the standard list; min track/space 0.10 mm; min drill 0.15 mm (standard page) / 0.20 mm (advanced page, conflict) | 2 L, 0.25/0.20 mm, 0.3 mm drill |
| SMT | yes, single/double side | 44 placements, top |
| THT | "SMT, Thru-Hole (THT) and hybrid of both" | 8 THT parts |
| THT soldering method | **NOT FOUND** on pages read | must be confirmed |
| Full turnkey | turnkey, partial turnkey, consigned | full turnkey |
| Customer-supplied parts | yes (consigned / partial) | option for U5 if stock is short |
| Substitution policy | states it asks for approval before parts decisions | "NO SUBSTITUTION without written approval" on every BOM line |
| Lead-free | leaded and lead-free assembly | lead-free required |
| Assembly MOQ | 5 pcs | — |
| Testing | AOI, X-ray, ICT, functional; flying probe | IPC-D-356 provided |
| Shipping to Saudi Arabia | Saudi Arabia appears in a DHL country list in search results: **INDICATED, not confirmed** | to confirm in the quote |

## Order parameters to request
2-layer FR-4 1.6 mm, 1 oz, 90 × 64 mm, ENIG (preferred), green mask, white silkscreen, single boards (no panel
needed). Turnkey assembly, top side only, 44 SMT + 8 THT, lead-free. Upload `Sensor_Interface_PCB_RevA_Complete_Manufacturing.zip`
or the separate fabrication and assembly ZIPs **only after the owner decides to order**.

## Open items before any order
THT method · TPS26600PWPR and SN74LVC1T45DBVR availability · CPL rotation convention · shipping, duties, price, lead time.
