AJC938/AI-PCB-Engineer/manufacturing/v0.2.0/manufacturer_profiles/NEXTPCB_ALTERNATE_PROFILE.md

# NextPCB — ALTERNATE manufacturer profile (not approved)

Status: **ALTERNATE** (scored 0.1 below PCBWay; see MANUFACTURER_SELECTION_RECOMMENDATION.md). No account,
upload, quote or order. Sources read 2026-11-09: https://www.nextpcb.com/pcb-capabilities,
https://www.nextpcb.com/pcb-assembly-services (assembly-capabilities page and PCBA guide blocked from here).

| Item | Published value | Design |
|---|---|---|
| 2-layer FR-4, 1.6 mm, 1 oz | listed | used |
| Trace/space (1 oz) | 3/3 mil | 0.25/0.20 mm |
| Min drill | 0.15 mm (≤ 1.2 mm boards); PTH tol ±0.075 | 0.3 mm vias |
| Copper to CNC edge | ≥ 0.2 mm | 0.5 mm |
| Silkscreen | ≥ 0.76 mm text, ≥ 0.12 mm line | 1.0 / 0.15 mm |
| Assembly | SMT, THT, mixed, single/double side; wave soldering line shown; lead-free | top-side mixed |
| Sourcing | Full turnkey, partial, consigned; HQ Online + global distributors | turnkey |
| MOQ | none (from 1 pc) | — |
| DFM/DFA | free on every order | — |
| Shipping | "ship to 166+ countries" via DHL/FedEx; Saudi Arabia not named on pages read | to confirm |
| Substitution policy | NOT FOUND on pages read | must be agreed in writing |
