AJC938/AI-PCB-Engineer/manufacturing/Sensor_Interface_Power_Board/RevA/assembly/Sensor_Interface_Power_Board_RevA_layers.pdf

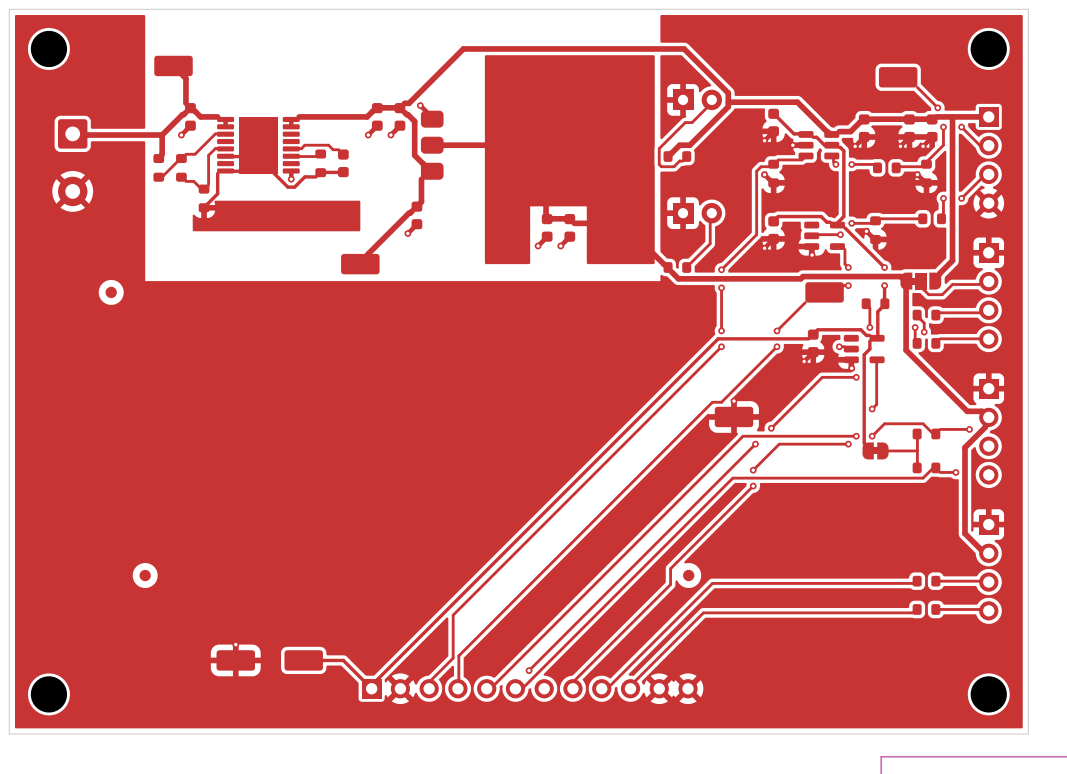
[picture p21: page 1]

Release v1.0.0 (Rev A) - fabrication-ready design, NOT physically tested
Architecture B: ESP32 DevKit on its own USB; board powers peripherals
2 layers FR-4 1.6 mm, 1 oz Cu, ENIG preferred, green mask, white silk
AI-PCB-Engineer
Sheet:
File: Sensor_Interface_Power_Board.kicad_pcb
Title: Sensor Interface & Power Management Board for ESP32

Size: A4 | Rev: A
KiCad E.D.A. 10.0.8 | Id: 1/7

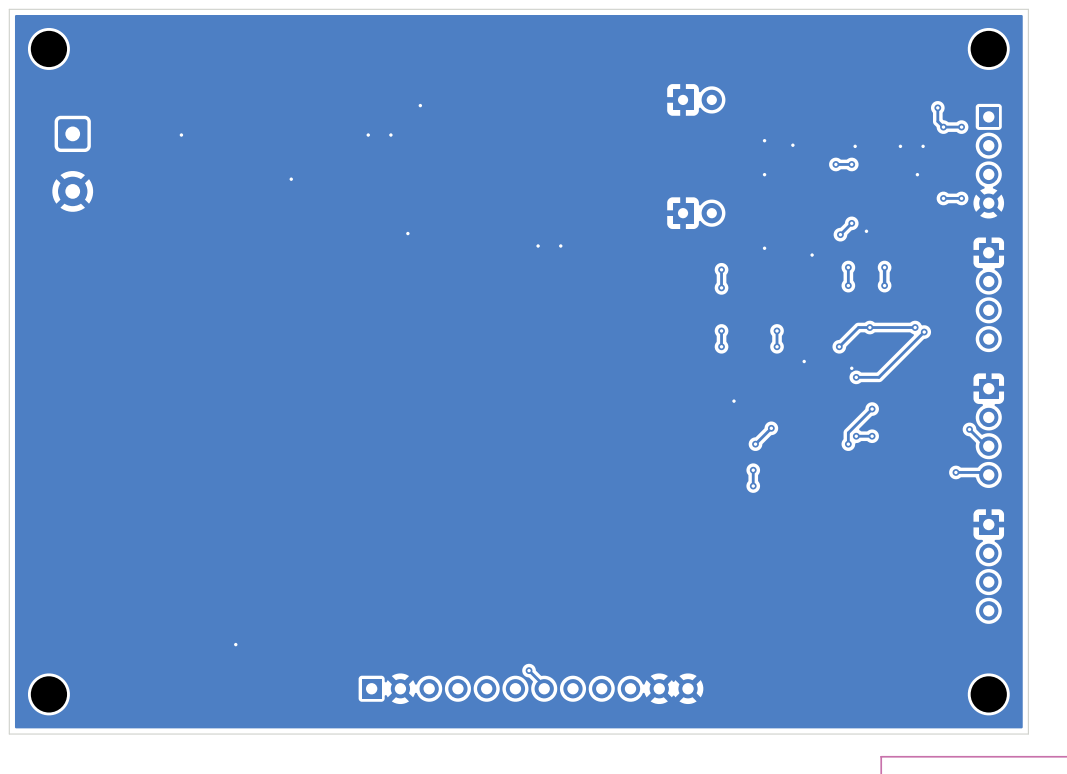
[picture p22: page 2]

Release v1.0.0 (Rev A) - fabrication-ready design, NOT physically tested
Architecture B: ESP32 DevKit on its own USB; board powers peripherals
2 layers FR-4 1.6 mm, 1 oz Cu, ENIG preferred, green mask, white silk
AI-PCB-Engineer
Sheet:
File: Sensor_Interface_Power_Board.kicad_pcb
Title: Sensor Interface & Power Management Board for ESP32

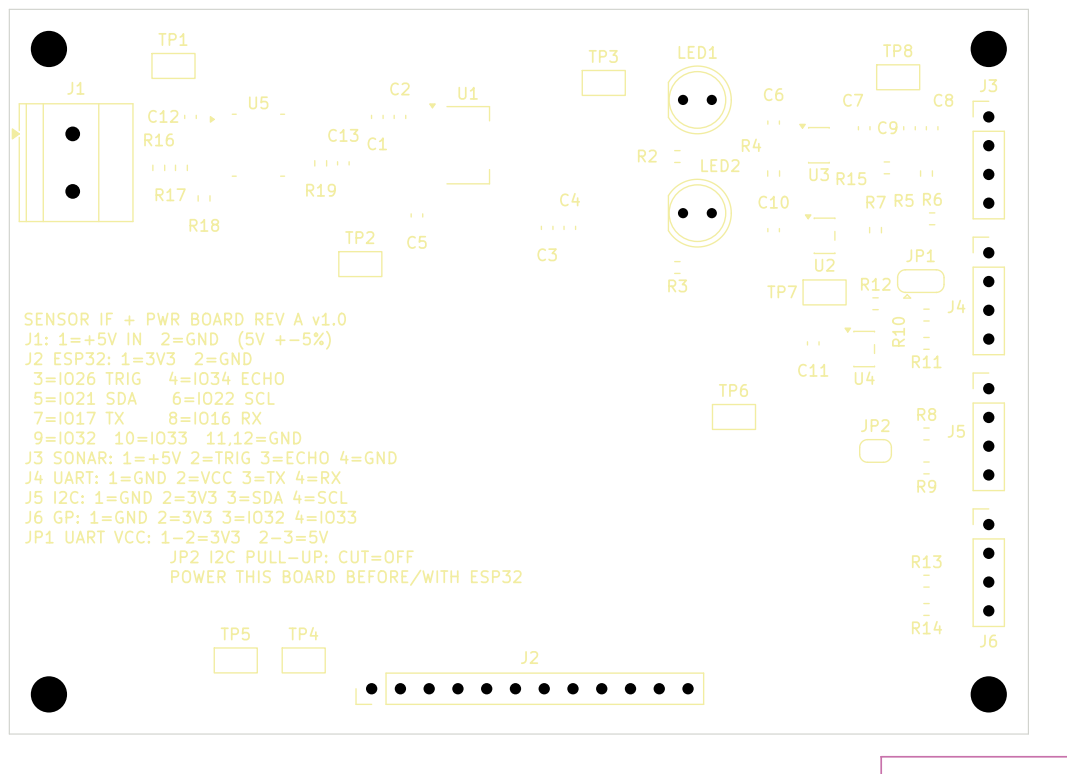
[picture p23: page 3]

SENSOR IF + PWR BOARD REV A v1.0
J1: 1=+5V IN 2=GND (5V +-5%) J4 UART: 1=GND 2=VCC 3=TX 4=RX
J2 ESP32: 1=3V3 2=GND

9=IO32 10=IO33 11,12=GND
J3 SONAR: 1=+5V 2=TRIG 3=ECHO 4=GND

Release v1.0.0 (Rev A) - fabrication-ready design, NOT physically tested
Architecture B: ESP32 DevKit on its own USB; board powers peripherals
2 layers FR-4 1.6 mm, 1 oz Cu, ENIG preferred, green mask, white silk
AI-PCB-Engineer
Sheet:
File: Sensor_Interface_Power_Board.kicad_pcb
Title: Sensor Interface & Power Management Board for ESP32

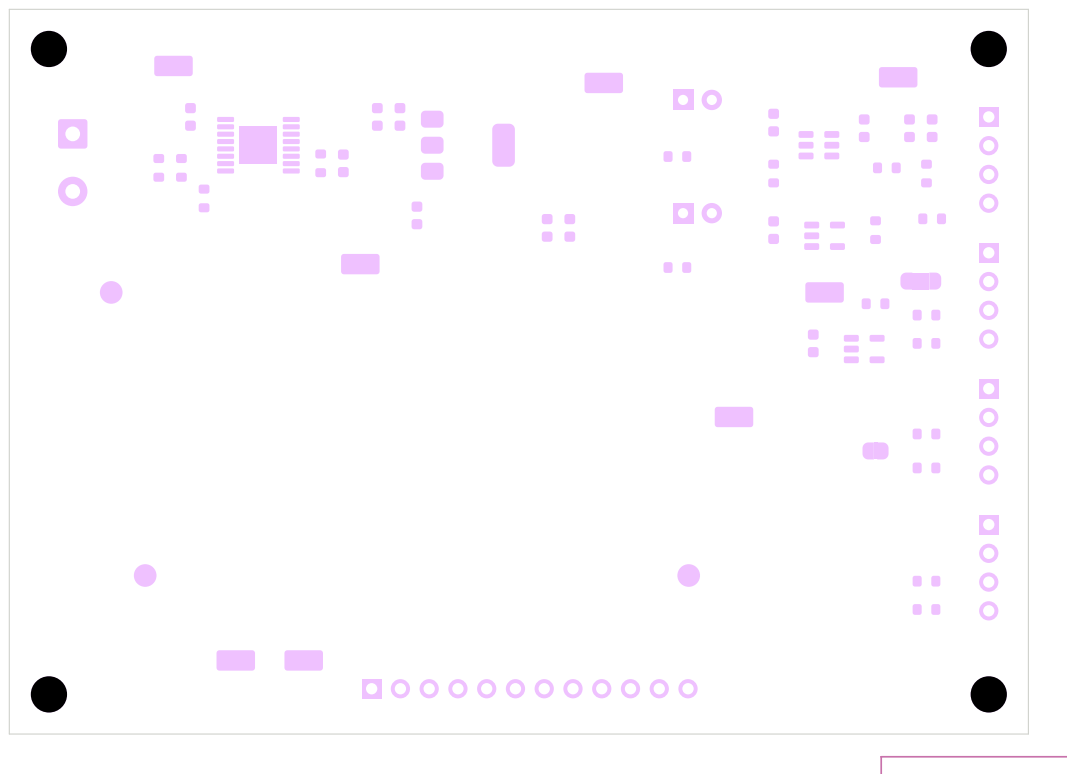
[picture p24: page 4]
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

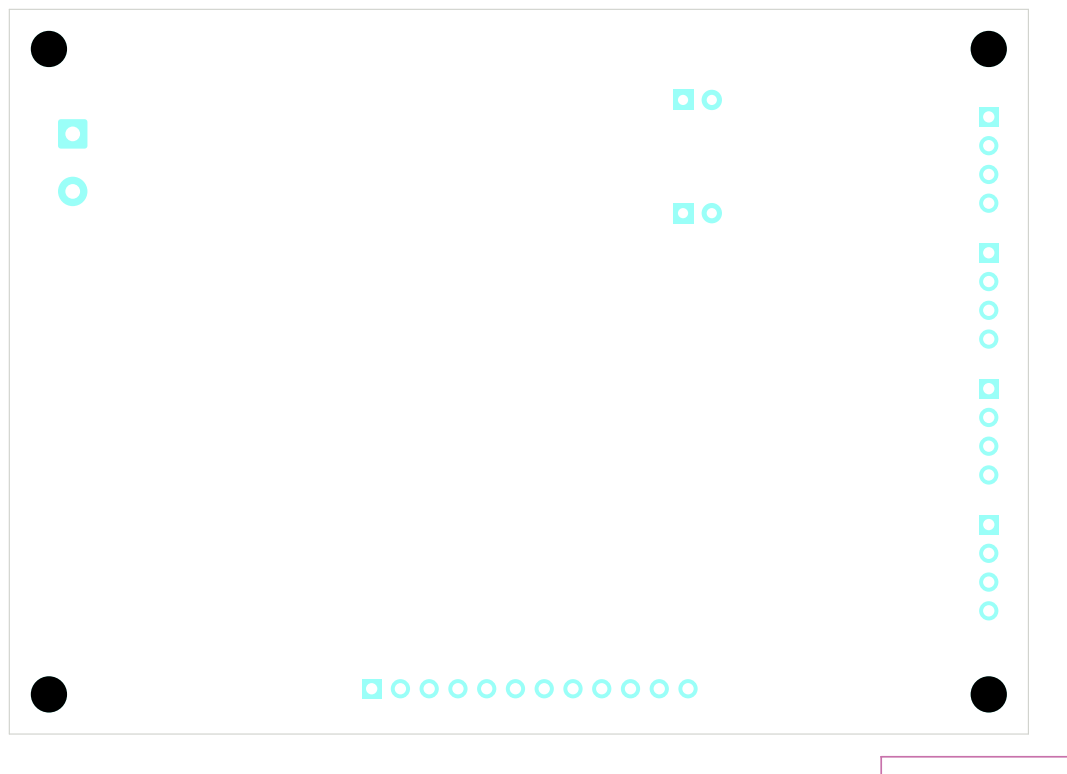
[picture p25: page 5]
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

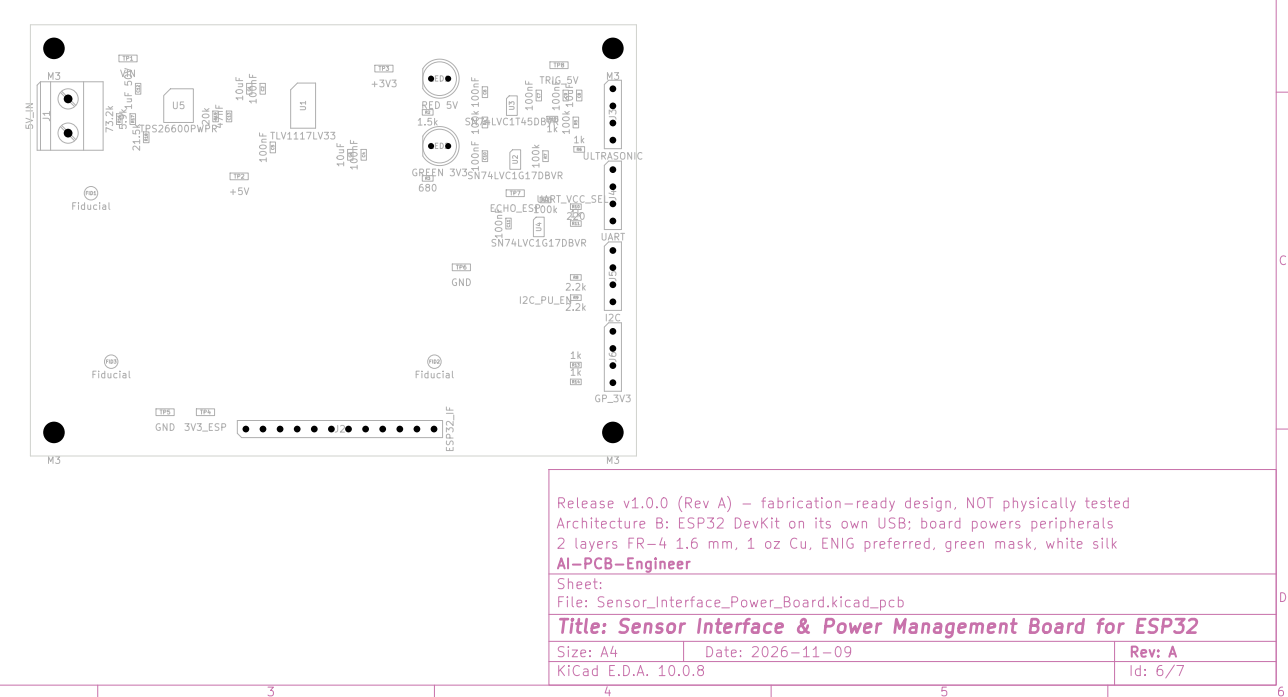
[picture p26: page 6]
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

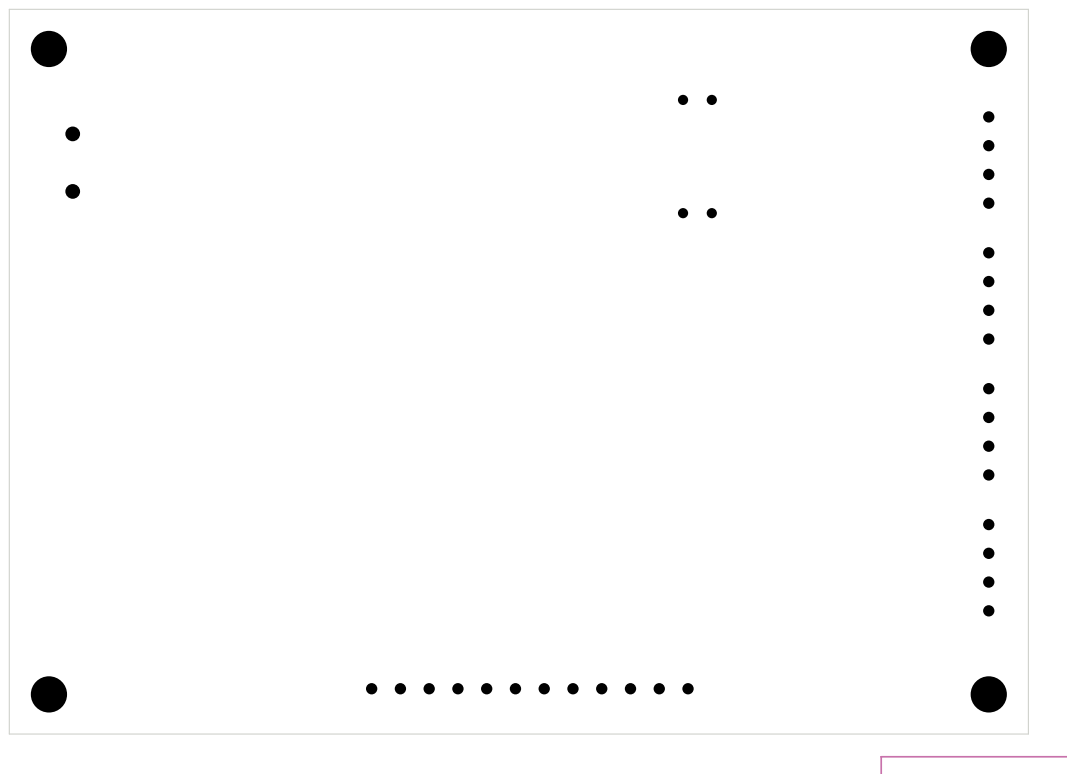
[picture p27: page 7]
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
