AJC938/AI-PCB-Engineer/reports/v0.2.0/MANUFACTURING_FILES_AUDIT.md

# Manufacturing Files Audit — V0.2.0

Files: `manufacturing/v0.2.0/gerbers/`, generated by kicad-cli 10.0.8 from the DRC-clean board (0/0/0). Audited
by `build/audit_fab_outputs.py`, which parses the files directly and compares them with the board through pcbnew.
Output: `evidence/validation/fab_audit_output.txt`. **Result: 11/11 PASS.**

| ID | Check | Result |
|---|---|---|
| G1 | 9 Gerber layers present with correct X2 `%TF.FileFunction` (Copper L1/L2, Soldermask, Paste, Legend, Profile) and `%MOMM` units. `%TF.ProjectId` carries **rev 0.2.0** | PASS |
| G2 | Edge.Cuts extents 0.000–90.000 × 0.000–64.000 mm at the aux origin (board bottom-left) | PASS |
| G3 | F.Paste: 107 flashes = 107 SMD paste pads (incl. U5 EP 3.3 × 3.3). B.Paste: 0 | PASS |
| D1 | PTH Excellon hits by diameter = board: 0.30 × 57 (vias), 0.90 × 4, 1.00 × 28, 1.30 × 2 | PASS |
| D2 | NPTH: 3.20 × 4 (mounting holes), separate file | PASS |
| C1–C4 | CPL vs board (see ASSEMBLY_PACKAGE_AUDIT.md) | PASS |
| B1 | BOM vs schematic | PASS |
| N1 | IPC-D-356: 39 nets, every routed net present | PASS |

## Visual inspection
Top copper + silkscreen, bottom copper, assembly drawings and 3D renders were inspected
(`evidence/images/pcb_top_copper_silk.png`, `pcb_bottom_copper.png`, `assembly_drawing_top_*.png`, `3d_*.png`).
- Orientation: not mirrored. J1 is on the left and the J2 pin 1 square pad is at the left end.
- Thermal copper appears around U1; the RTN island is separate from GND.
- The bottom copper is a continuous plane with short crossings.
- The silkscreen legend is readable at 1.0 mm.
- No silk on pads (DRC 0).

## Job/stack-up file
`Sensor_Interface_Power_Board-job.gbrjob`: 2 layers, 1.6 mm, FR-4 1.51 mm core, 35 µm copper, 10 µm mask.
The finish field reads "None" (not set in the KiCad stack-up). **ENIG/HASL is specified in FABRICATION_NOTES.md
and must be selected in the order form.**

Not covered by this audit: viewing in a third-party Gerber viewer (e.g. the manufacturer's online viewer, which
would require an upload — not permitted). The vendor's DFM check before production remains required.
