AJC938/AI-PCB-Engineer/manufacturing/v0.2.0/assembly/Sensor_Interface_Power_Board_v0.2.0_assembly_drawing_bottom.pdf

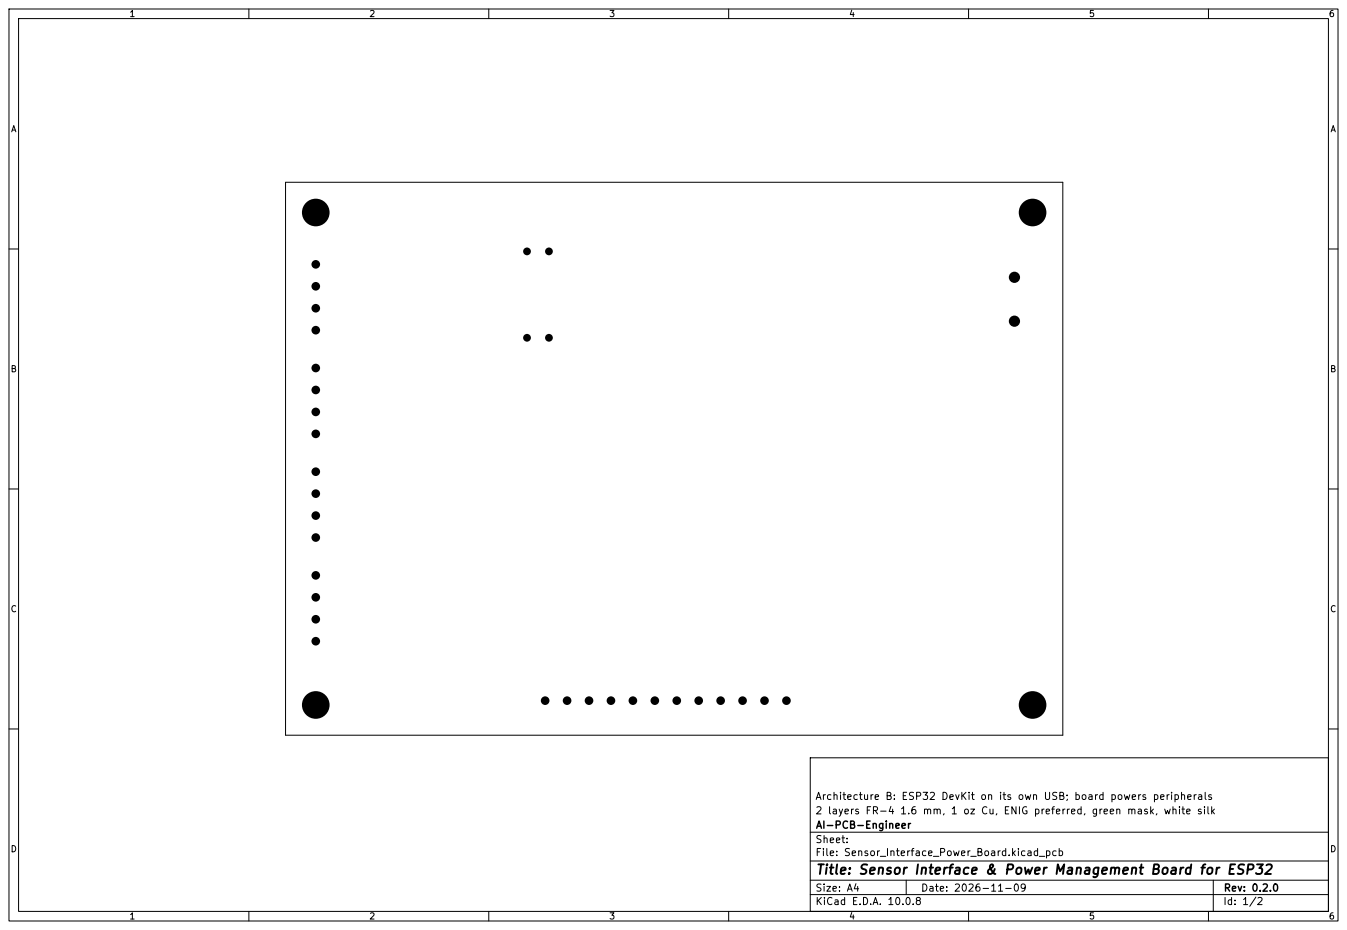
[picture p28: page 1]

Architecture B: ESP32 DevKit on its own USB; board powers peripherals
2 layers FR-4 1.6 mm, 1 oz Cu, ENIG preferred, green mask, white silk
AI-PCB-Engineer
Sheet:
File: Sensor_Interface_Power_Board.kicad_pcb
Title: Sensor Interface & Power Management Board for ESP32

Size: A4 | Rev: 0.2.0
KiCad E.D.A. 10.0.8 | Id: 1/2

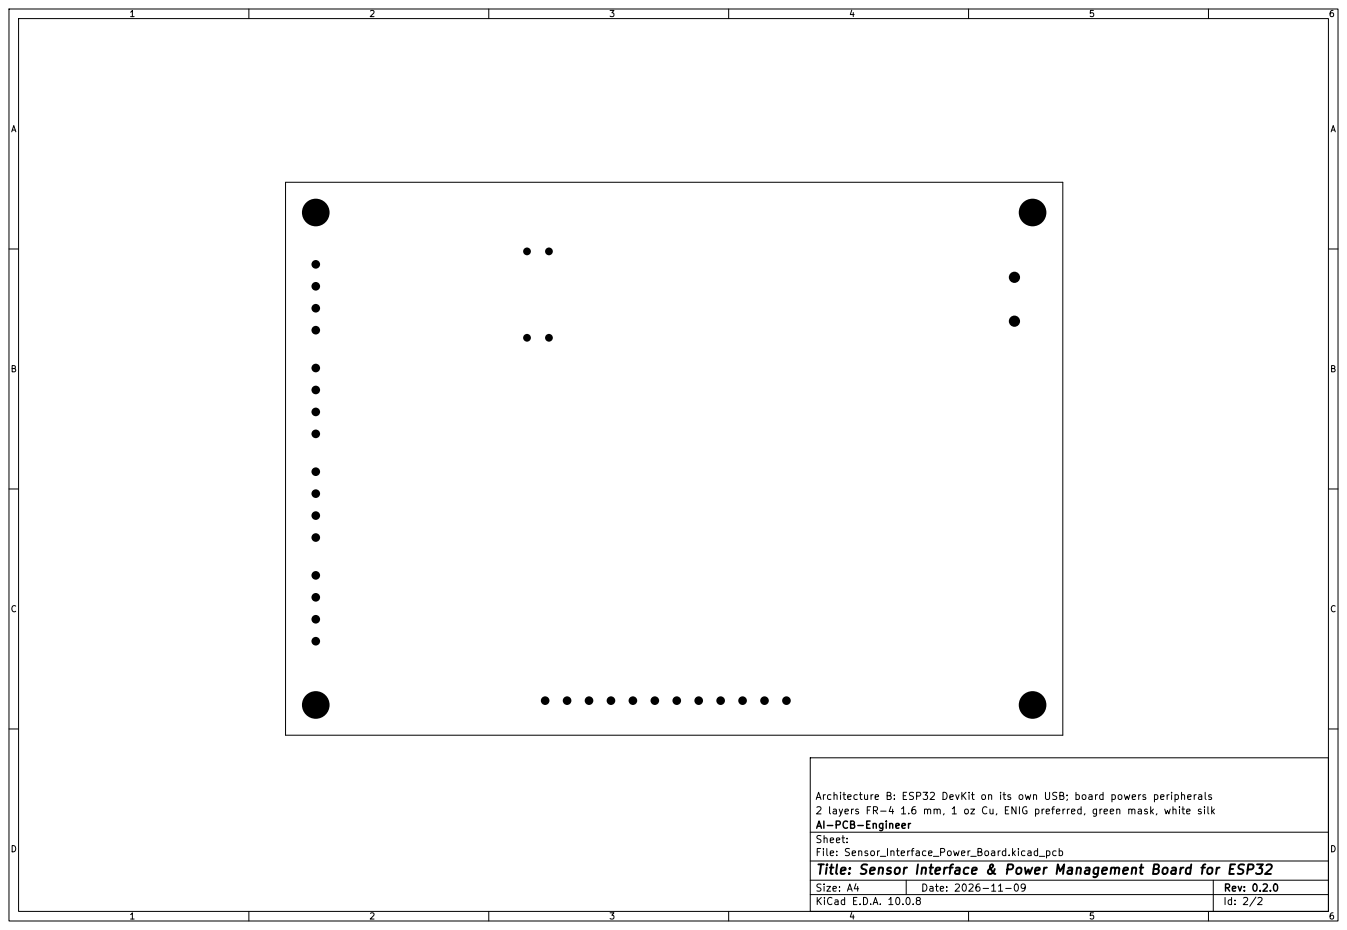
[picture p29: page 2]
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

Size: A4 | Rev: 0.2.0
KiCad E.D.A. 10.0.8 | Id: 2/2
