AJC938/AI-PCB-Engineer/manufacturing/v0.2.0/assembly/Sensor_Interface_Power_Board_v0.2.0_layers.pdf

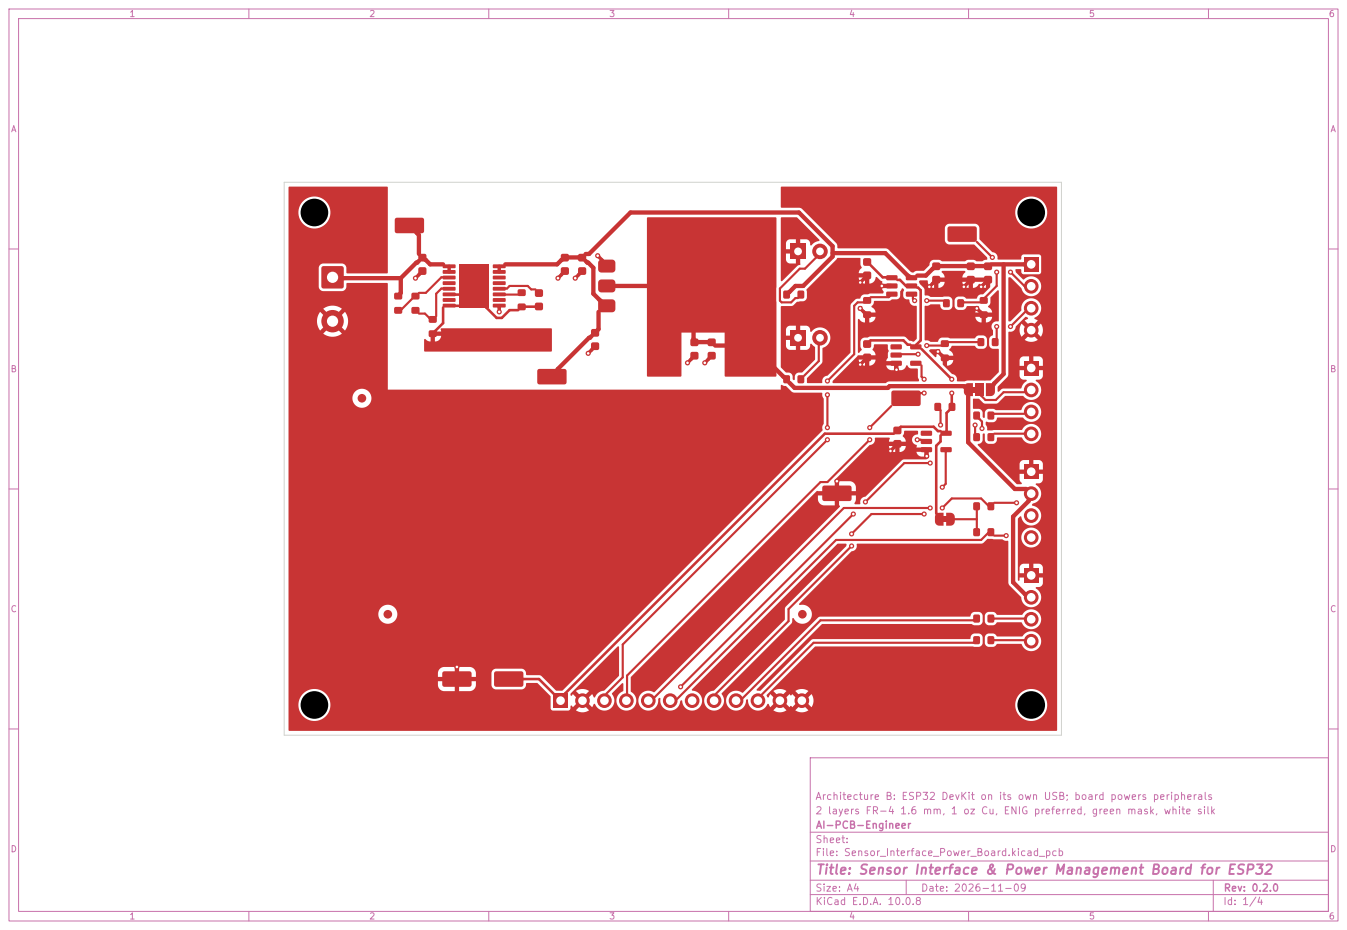
[picture p32: page 1]

Architecture B: ESP32 DevKit on its own USB; board powers peripherals
2 layers FR-4 1.6 mm, 1 oz Cu, ENIG preferred, green mask, white silk
AI-PCB-Engineer
Sheet:
File: Sensor_Interface_Power_Board.kicad_pcb
Title: Sensor Interface & Power Management Board for ESP32

Size: A4 | Rev: 0.2.0
KiCad E.D.A. 10.0.8 | Id: 1/4

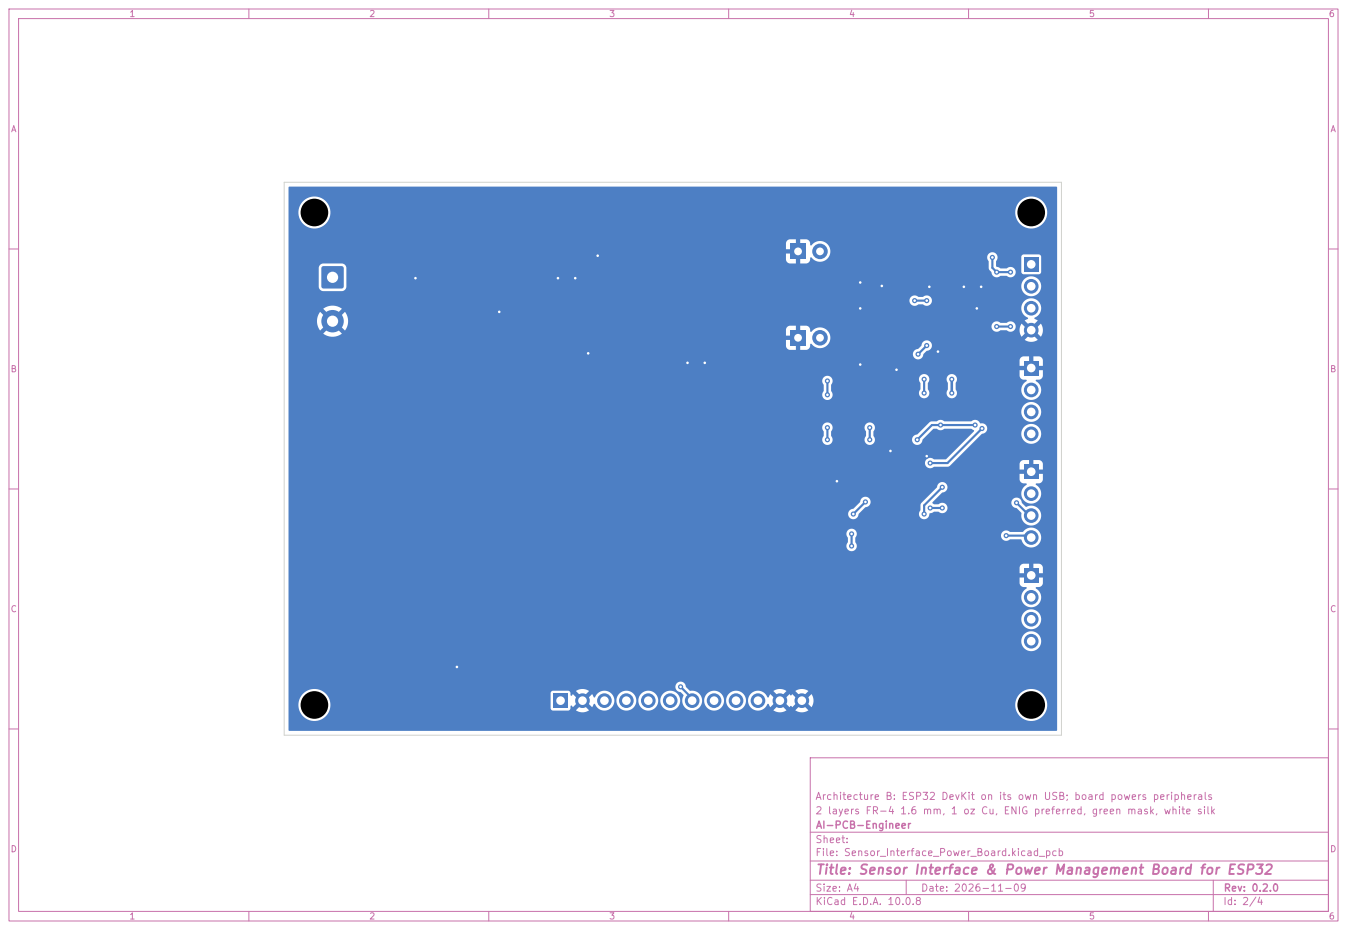
[picture p33: page 2]
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

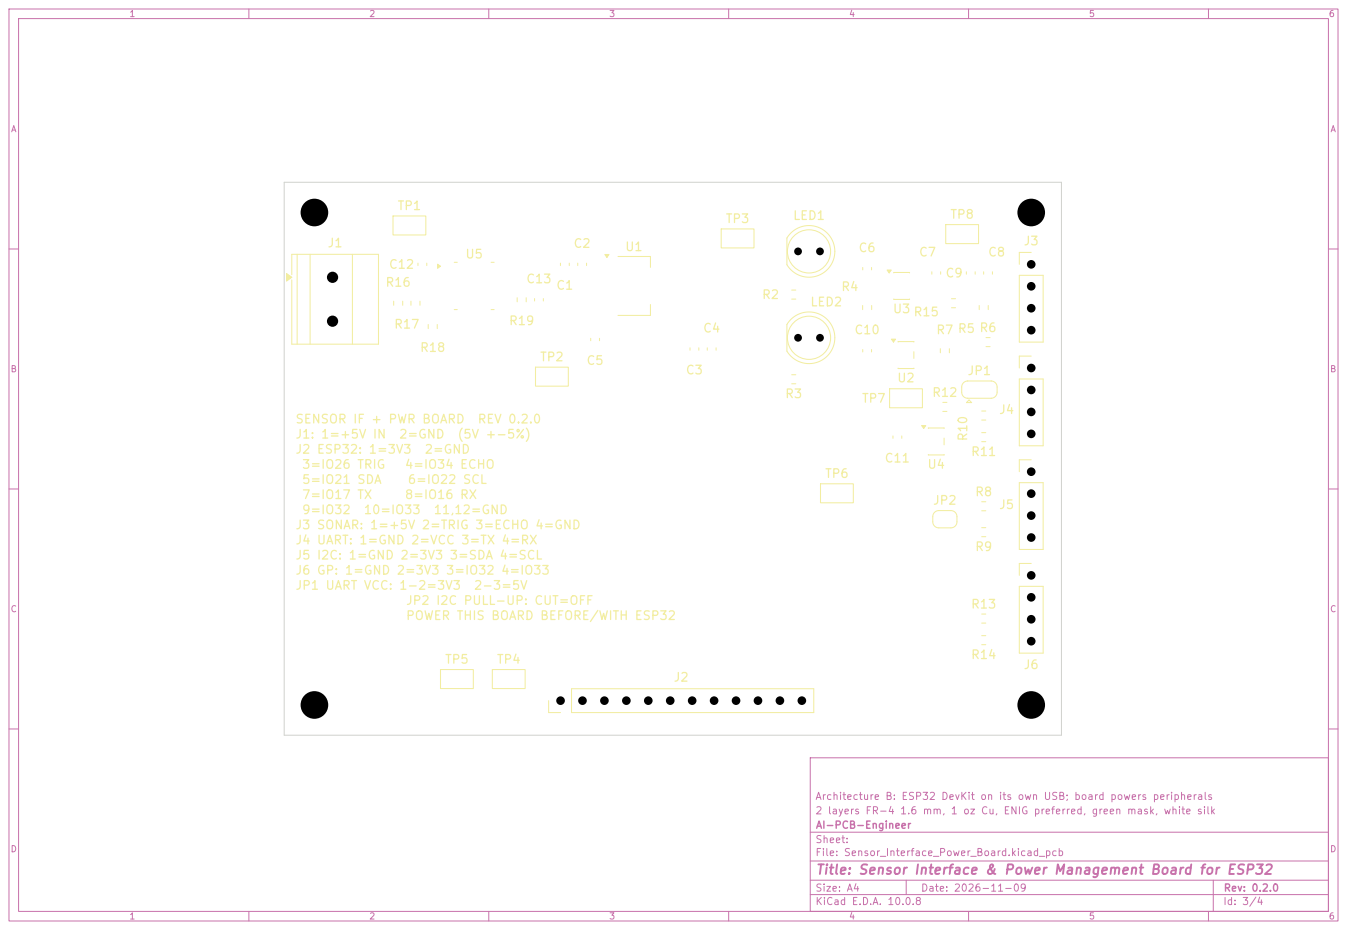
[picture p34: page 3]

SENSOR IF + PWR BOARD REV 0.2.0
J1: 1=+5V IN 2=GND (5V +-5%)
J2 ESP32: 1=3V3 2=GND
9=IO32 10=IO33 11,12=GND
J3 SONAR: 1=+5V 2=TRIG 3=ECHO 4=GND
J4 UART: 1=GND 2=VCC 3=TX 4=RX
J5 I2C: 1=GND 2=3V3 3=SDA 4=SCL
J6 GP: 1=GND 2=3V3 3=IO32 4=IO33
JP1 UART VCC: 1-2=3V3 2-3=5V

JP2 I2C PULL-UP: CUT=OFF
POWER THIS BOARD BEFORE/WITH ESP32

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

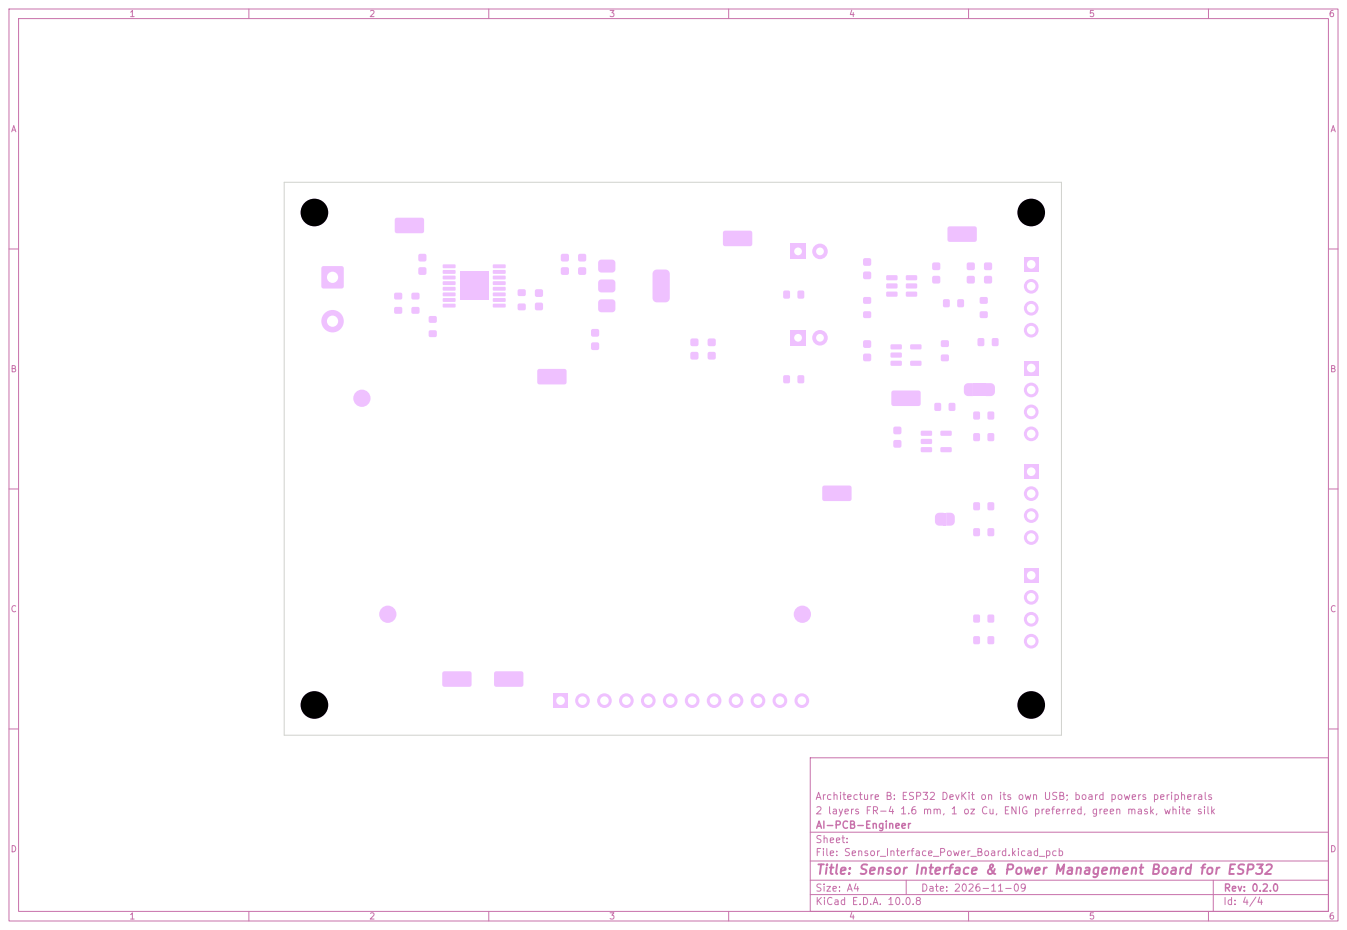
[picture p35: page 4]
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
