AJC938/AI-PCB-Engineer/manufacturing/v0.2.0/assembly/Sensor_Interface_Power_Board_v0.2.0_schematic.pdf

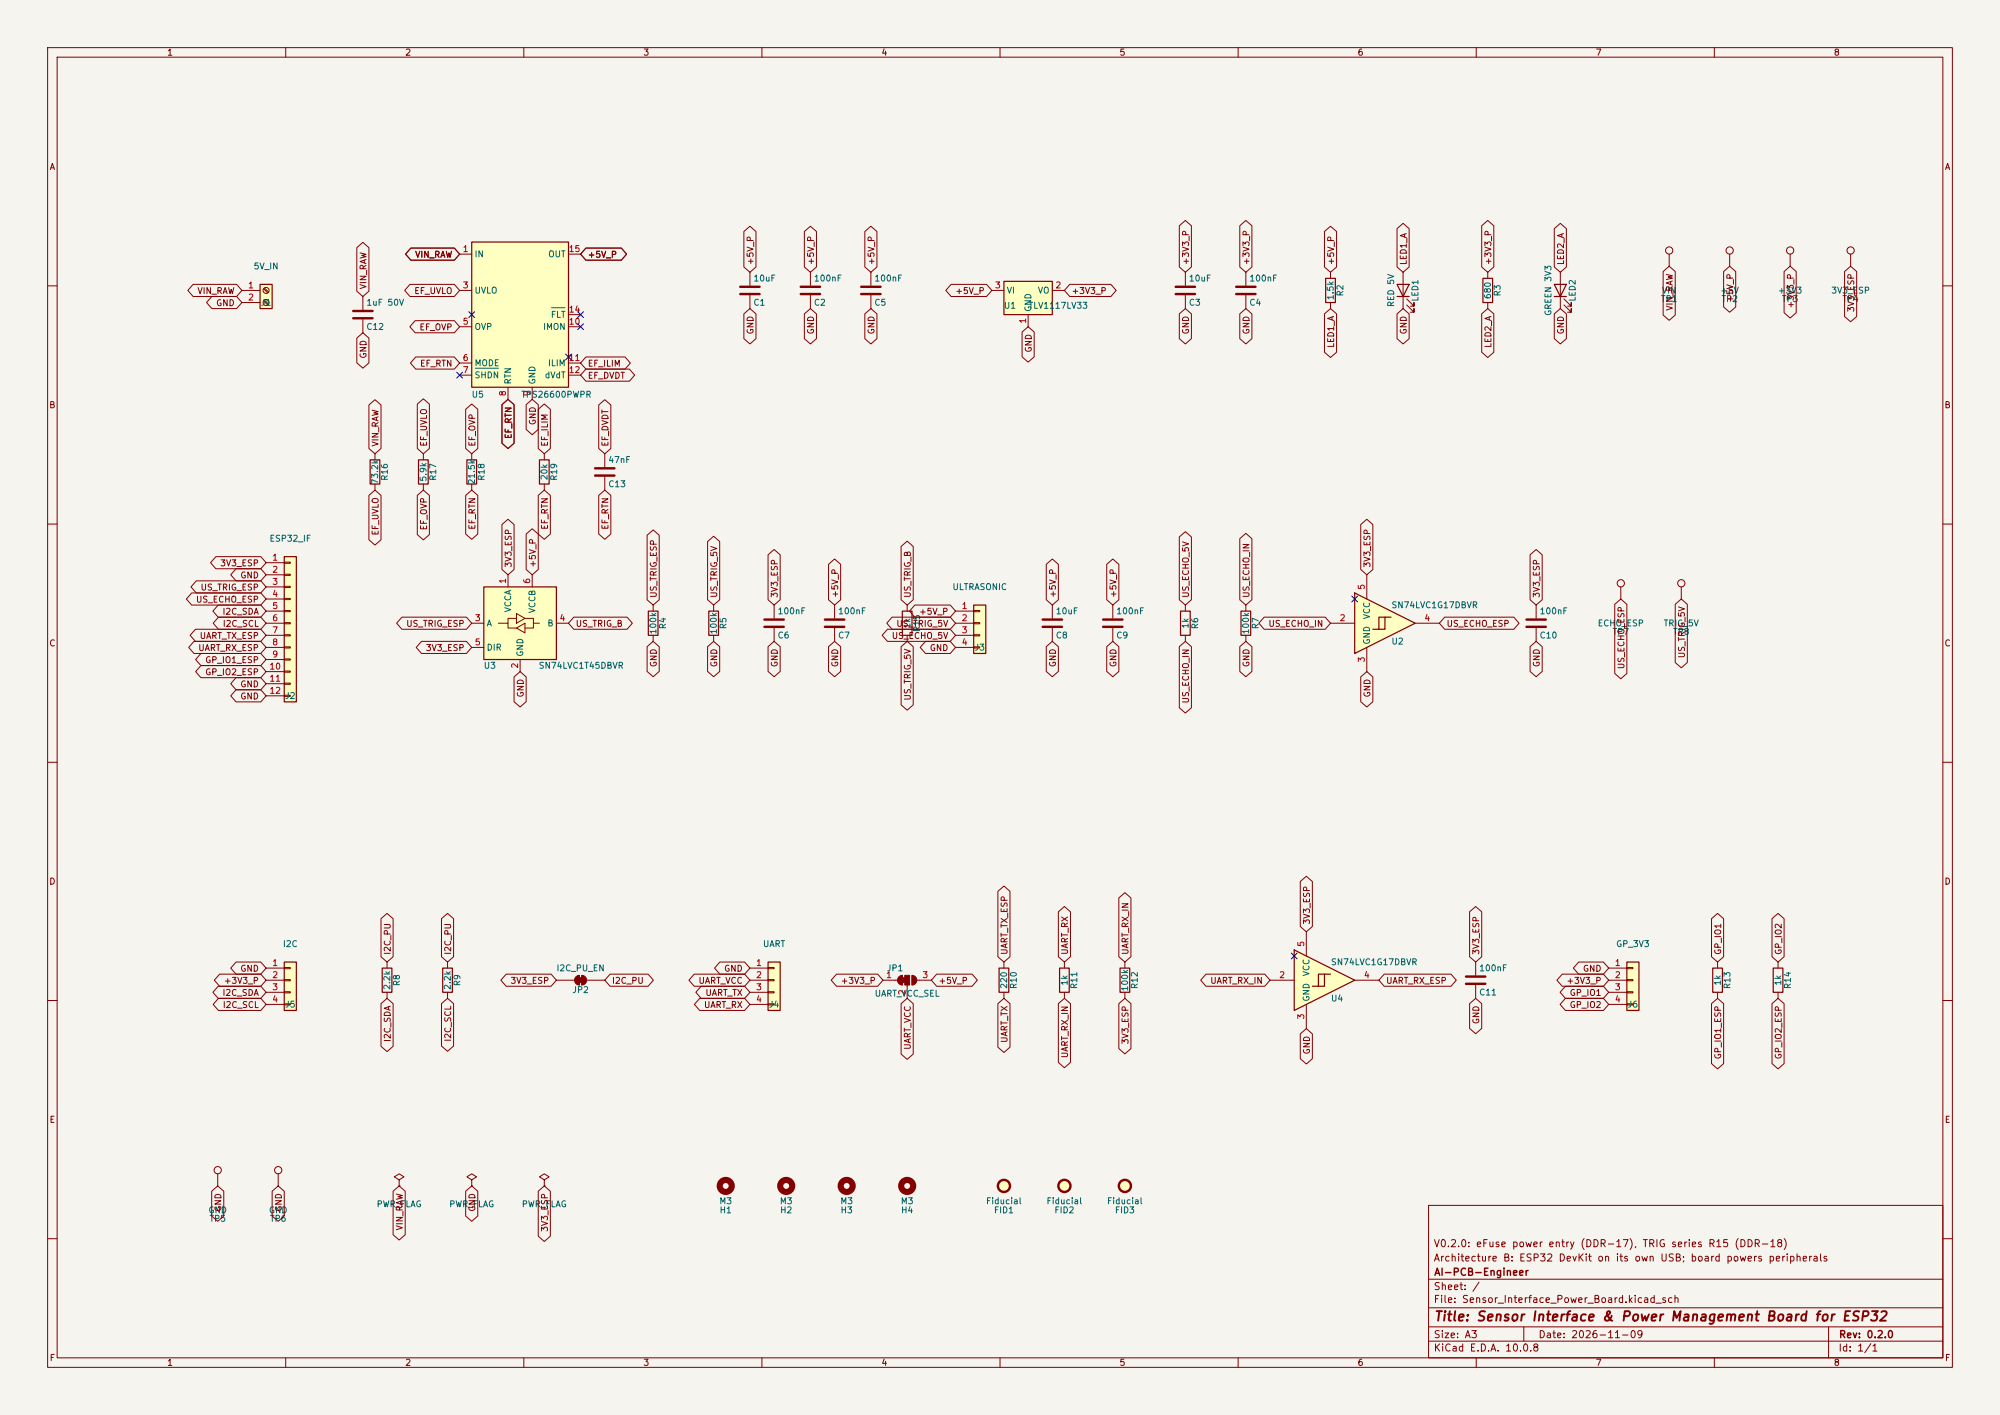
[picture p36: page 1]

Architecture B: ESP32 DevKit on its own USB; board powers peripherals
AI-PCB-Engineer
Sheet: /
File: Sensor_Interface_Power_Board.kicad_sch
Title: Sensor Interface & Power Management Board for ESP32

Size: A3 | Rev: 0.2.0 | F Date: 2026-11-09
KiCad E.D.A. 10.0.8 | Id: 1/1
