AJC938/AI-PCB-Engineer/manufacturing/Sensor_Interface_Power_Board/RevA/assembly/Sensor_Interface_Power_Board_RevA_schematic.pdf

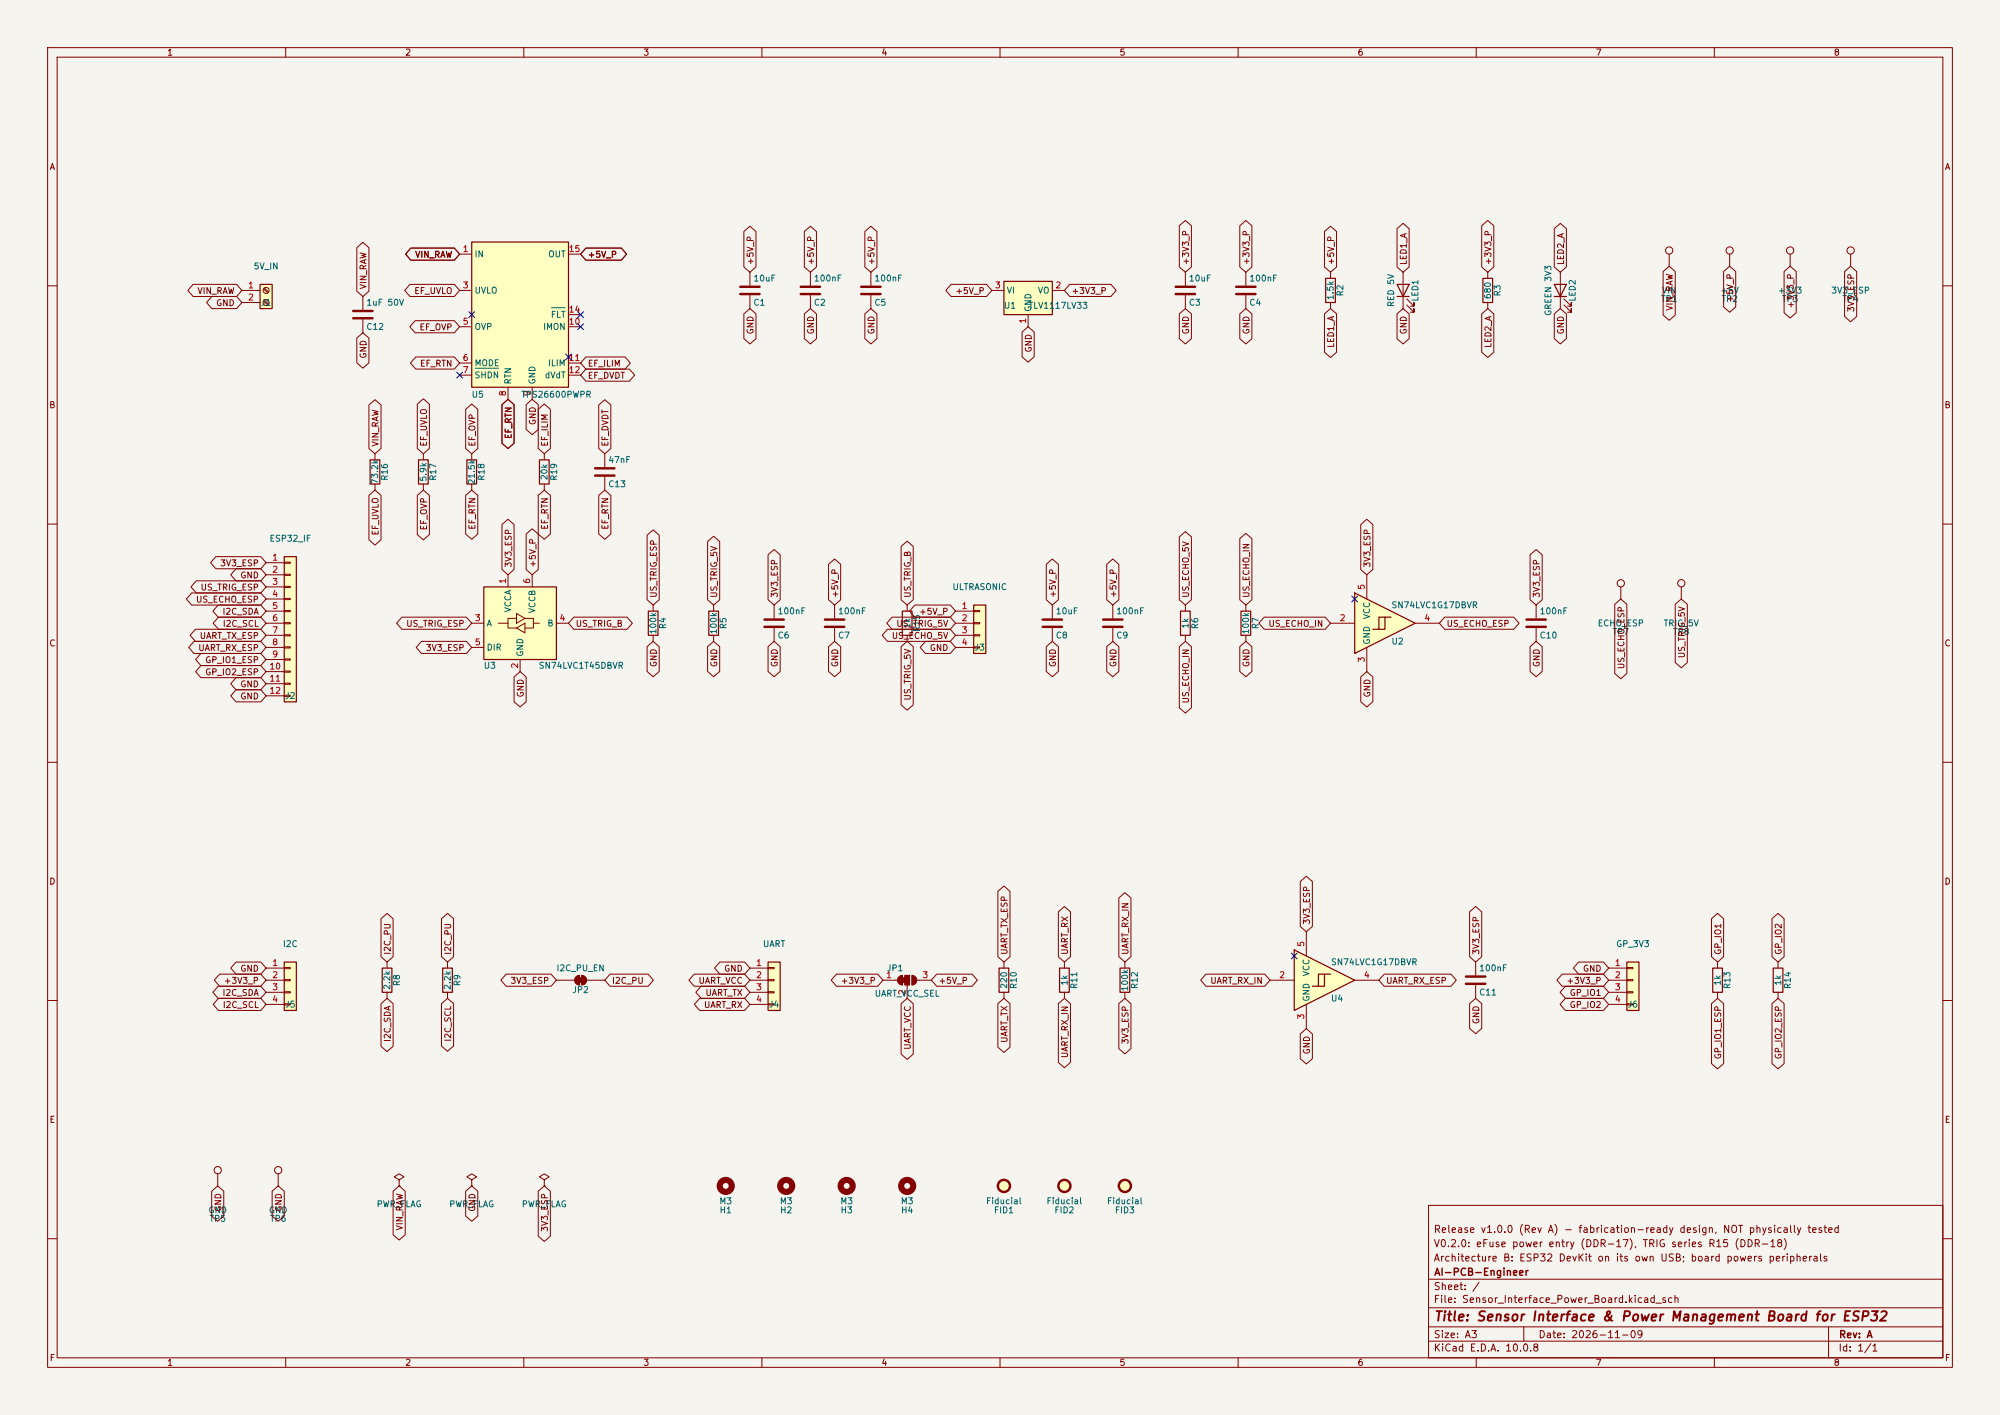
[picture p37: page 1]

V0.2.0: eFuse power entry (DDR-17), TRIG series R15 (DDR-18)
Architecture B: ESP32 DevKit on its own USB; board powers peripherals
AI-PCB-Engineer
Sheet: /
File: Sensor_Interface_Power_Board.kicad_sch
Title: Sensor Interface & Power Management Board for ESP32

Size: A3 | Rev: A | F Date: 2026-11-09
KiCad E.D.A. 10.0.8 | Id: 1/1
