AJC938/AI-PCB-Engineer/reports/v0.0.2/evidence/fab/led_test-schematic.pdf

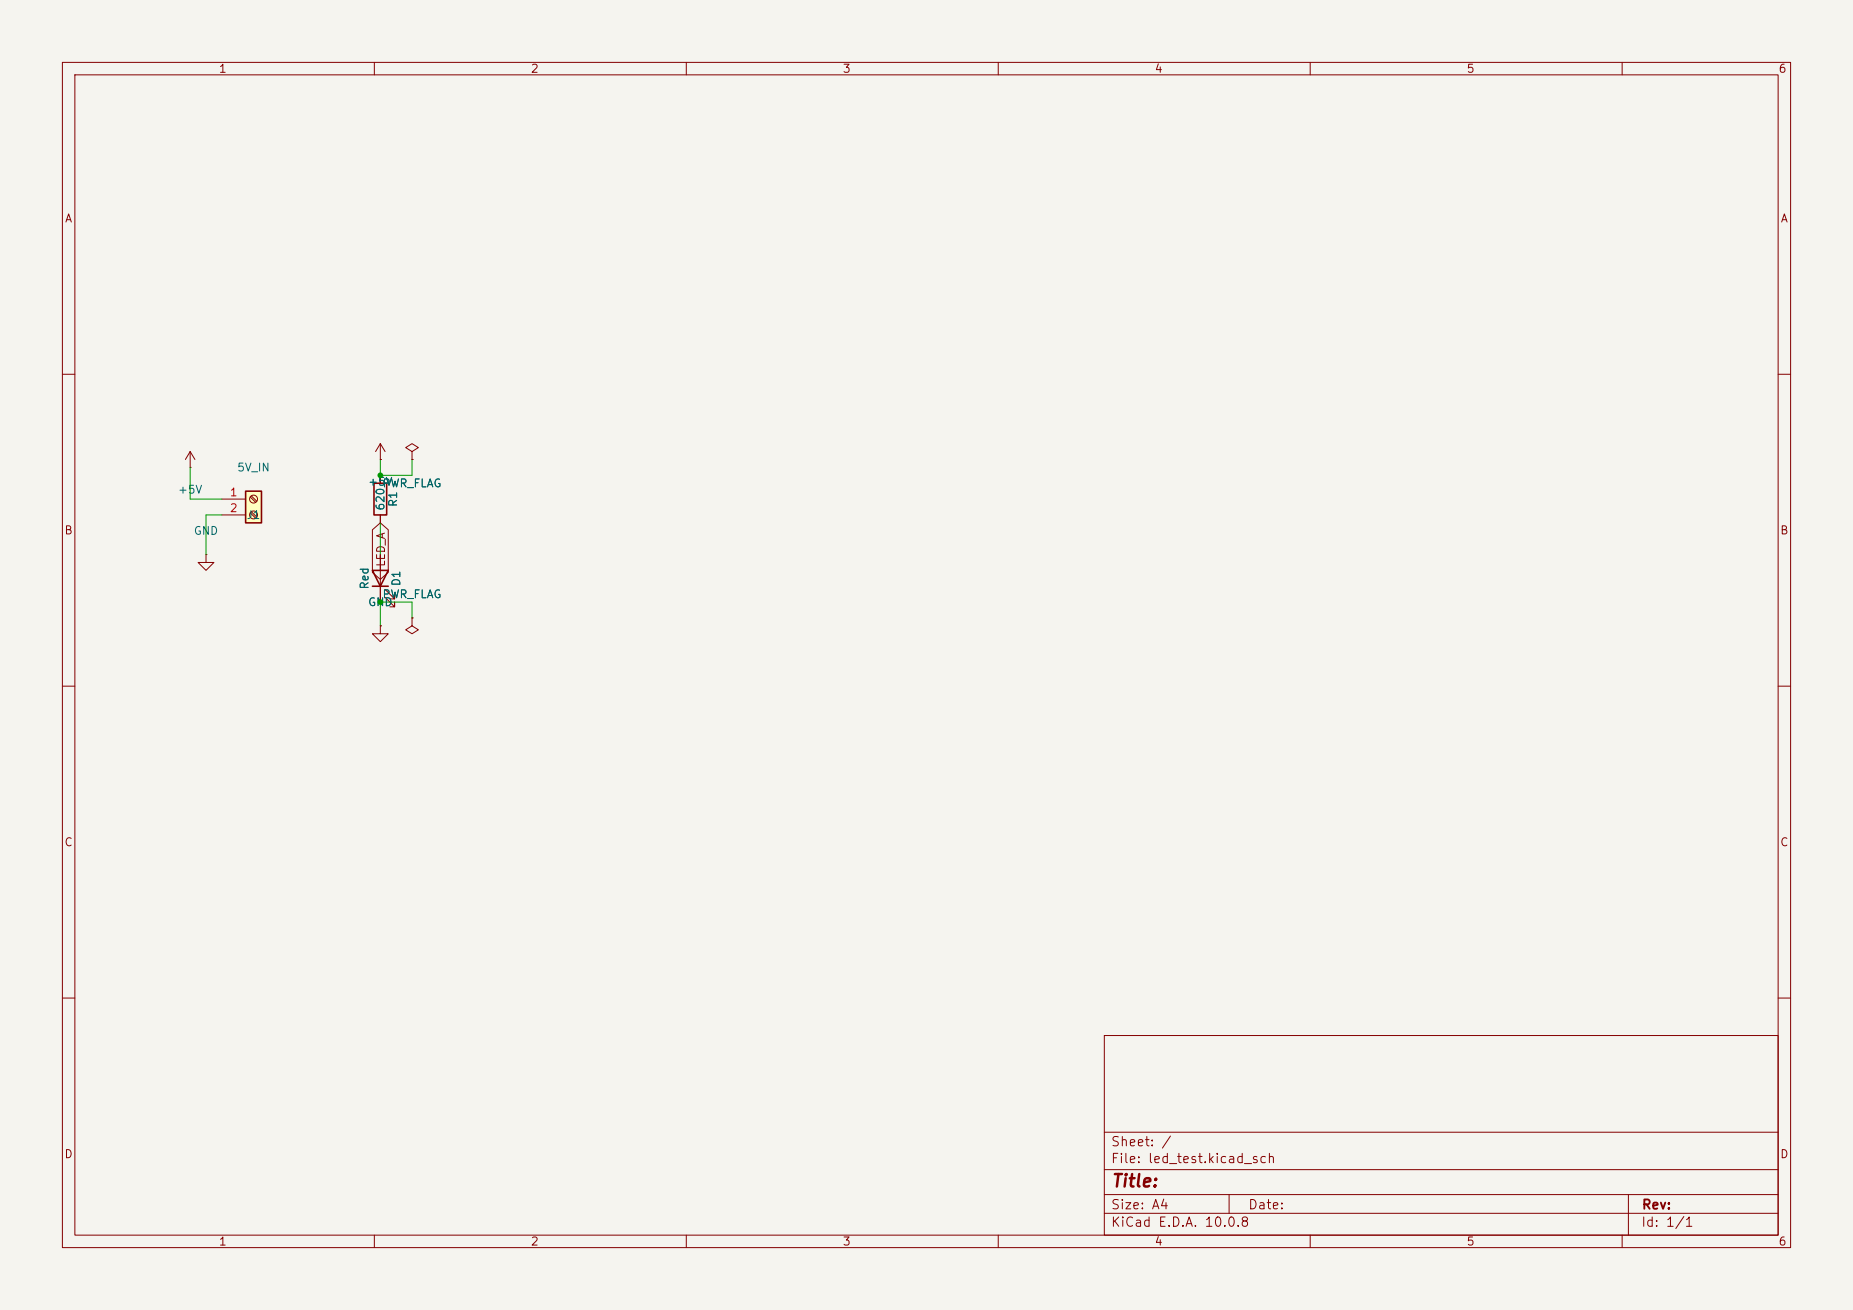
[picture p38: page 1]

Size: A4 | Rev:
KiCad E.D.A. 10.0.8 | Id: 1/1
