AJC938/AI-PCB-Engineer/reports/v0.0.2/evidence/fab/led_test-pcb.pdf

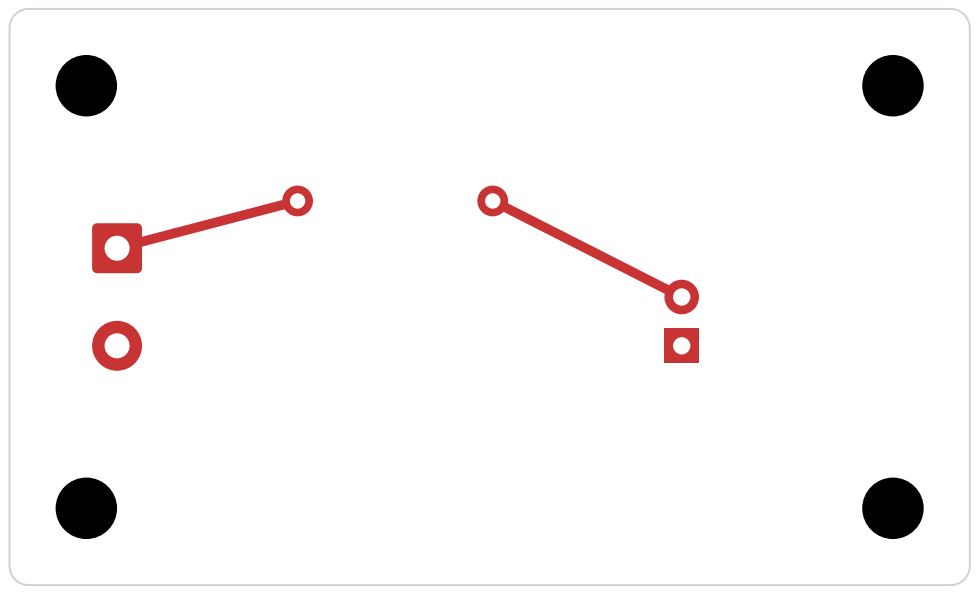
[picture p39: page 1]

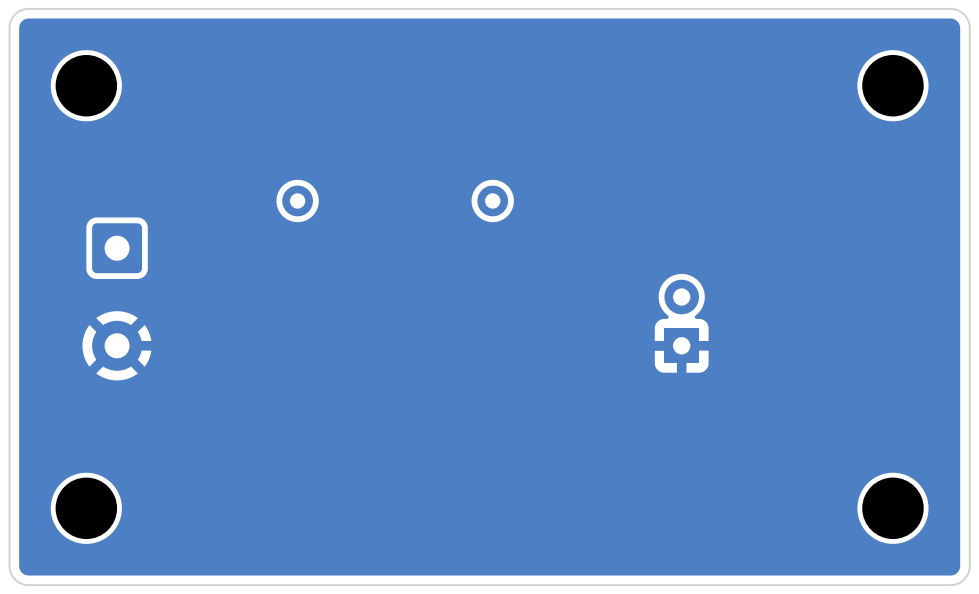
[picture p40: page 2]

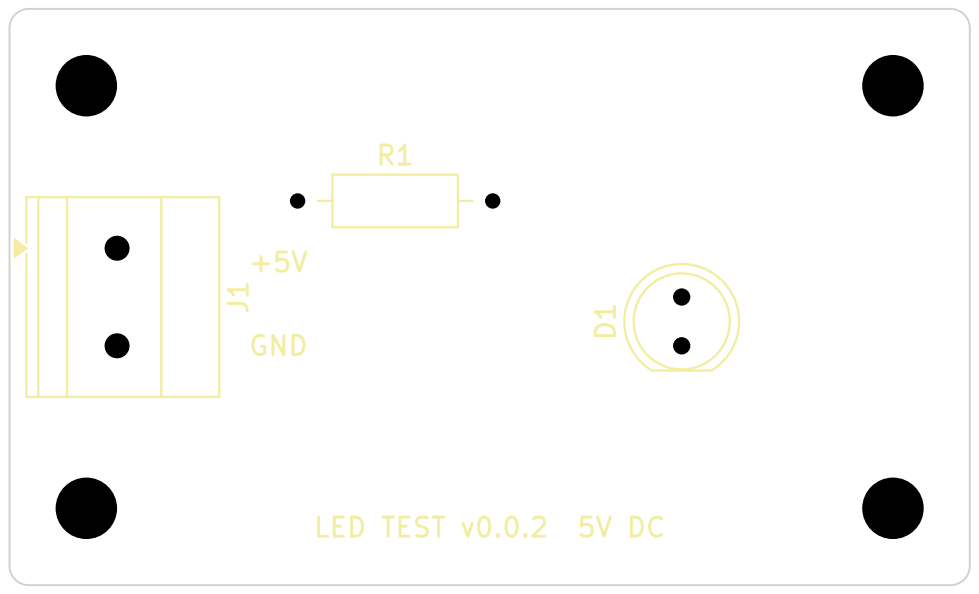
[picture p41: page 3]

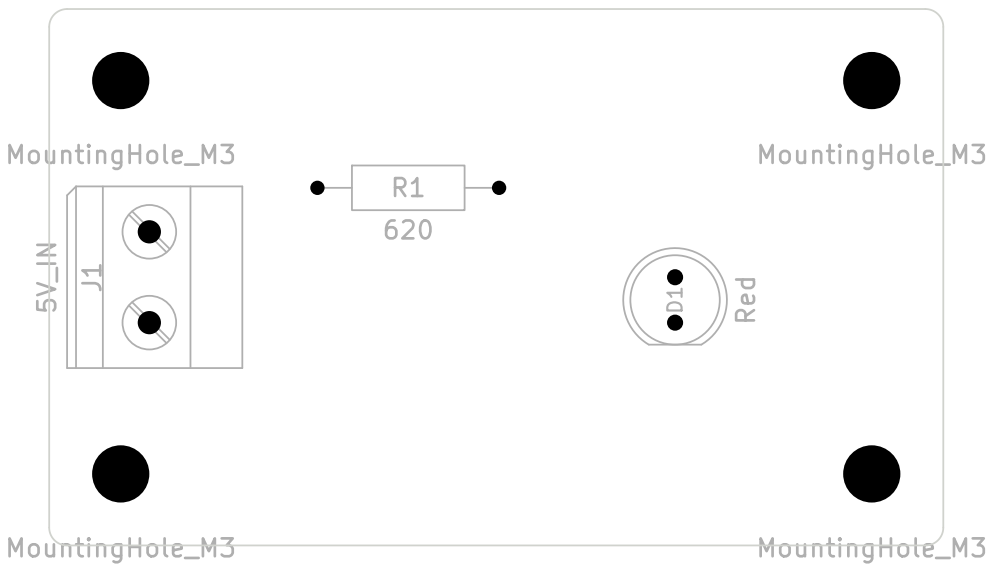
[picture p42: page 4]
