AJC938/AI-PCB-Engineer/(list of files, drawings)

Other design files:
reports/v0.2.0/evidence/layout/pcb_state_before_routing.json
