AJC938/AI-PCB-Engineer/hardware/kicad/Sensor_Interface_Power_Board/Sensor_Interface_Power_Board.kicad_pcb

## KiCad design hardware/kicad/Sensor_Interface_Power_Board/Sensor_Interface_Power_Board.kicad_pcb (2026-11-09)

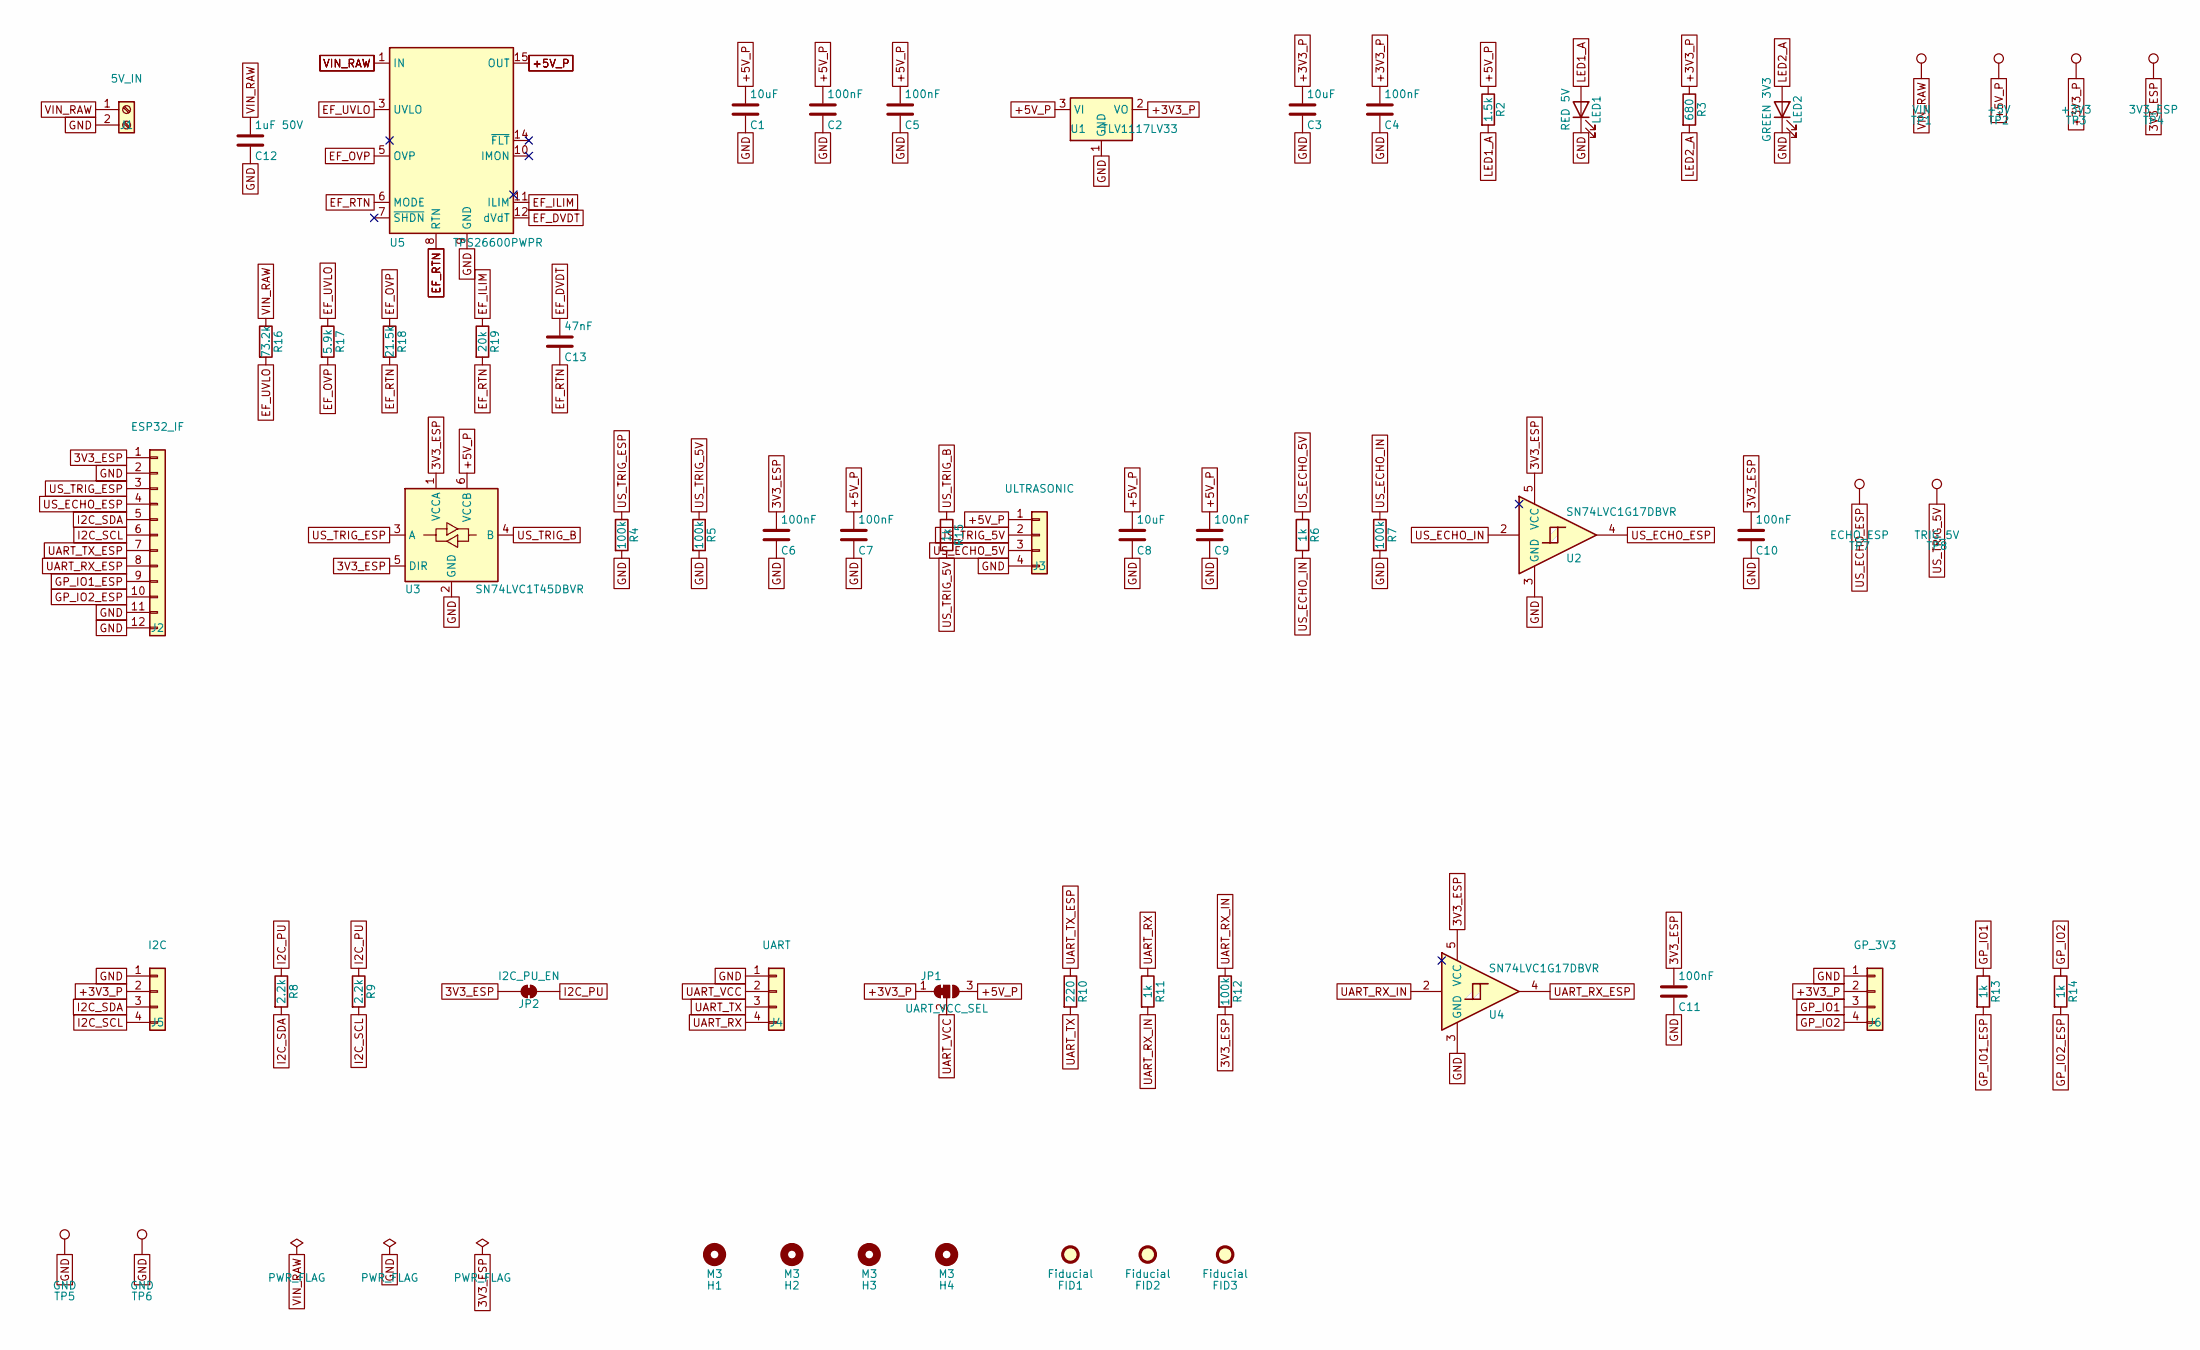
[picture p43: schematic Sensor_Interface_Power_Board.kicad_sch, Sensor Interface & Power Management Board for ESP32]

Parts:
C1, C3, C8: 10uF; C_0603_1608Metric; MPN CL10A106KP8NNNC
C2, C4, C5, C6, C7, C9, C10, C11: 100nF; C_0603_1608Metric; MPN GRM188R71C104KA01D
C12: 1uF 50V; C_0603_1608Metric; MPN CL10A105KB8NNNC
C13: 47nF; C_0603_1608Metric; MPN CL10B473KB8NNNC
FID1, FID2, FID3: Fiducial; Fiducial_1mm_Mask2mm
H1, H2, H3, H4: M3; MountingHole_3.2mm_M3
J1: 5V_IN; TerminalBlock_Phoenix_MKDS-1,5-2-5.08_1x02_P5.08mm_Horizont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; MPN 1715721
J2: ESP32_IF; PinHeader_1x12_P2.54mm_Vertical; MPN HTSW-112-07-T-S
J3: ULTRASONIC; PinHeader_1x04_P2.54mm_Vertical; MPN HTSW-104-07-T-S
J4: UART; PinHeader_1x04_P2.54mm_Vertical; MPN HTSW-104-07-T-S
J5: I2C; PinHeader_1x04_P2.54mm_Vertical; MPN HTSW-104-07-T-S
J6: GP_3V3; PinHeader_1x04_P2.54mm_Vertical; MPN HTSW-104-07-T-S
JP1: UART_VCC_SEL; SolderJumper-3_P1.3mm_Bridged12_RoundedPad1.0x1.5mm
JP2: I2C_PU_EN; SolderJumper-2_P1.3mm_Bridged_RoundedPad1.0x1.5mm
LED1: RED 5V; LED_D5.0mm; MPN WP7113ID
LED2: GREEN 3V3; LED_D5.0mm; MPN WP7113SGD
R2: 1.5k; R_0603_1608Metric; MPN ERJ-3EKF1501V
R3: 680; R_0603_1608Metric; MPN ERJ-3EKF6800V
R4, R5, R7, R12: 100k; R_0603_1608Metric; MPN ERJ-3EKF1003V
R6, R11, R13, R14, R15: 1k; R_0603_1608Metric; MPN ERJ-3EKF1001V
R8, R9: 2.2k; R_0603_1608Metric; MPN ERJ-3EKF2201V
R10: 220; R_0603_1608Metric; MPN ERJ-3EKF2200V
R16: 73.2k; R_0603_1608Metric; MPN ERJ-3EKF7322V
R17: 5.9k; R_0603_1608Metric; MPN ERJ-3EKF5901V
R18: 21.5k; R_0603_1608Metric; MPN ERJ-3EKF2152V
R19: 20k; R_0603_1608Metric; MPN ERJ-3EKF2002V
TP1: VIN; TestPoint_Keystone_5015_Micro_Mini; MPN 5015
TP2: +5V; TestPoint_Keystone_5015_Micro_Mini; MPN 5015
TP3: +3V3; TestPoint_Keystone_5015_Micro_Mini; MPN 5015
TP4: 3V3_ESP; TestPoint_Keystone_5015_Micro_Mini; MPN 5015
TP5, TP6: GND; TestPoint_Keystone_5015_Micro_Mini; MPN 5015
TP7: ECHO_ESP; TestPoint_Keystone_5015_Micro_Mini; MPN 5015
TP8: TRIG_5V; TestPoint_Keystone_5015_Micro_Mini; MPN 5015
U1: TLV1117LV33; SOT-223-3_TabPin2; MPN TLV1117LV33DCYR
U2, U4: SN74LVC1G17DBVR; SOT-23-5; MPN SN74LVC1G17DBVR
U3: SN74LVC1T45DBVR; SOT-23-6; MPN SN74LVC1T45DBVR
U5: TPS26600PWPR; TI_PWP0016A_HTSSOP-16-1EP_4.4x5mm_P0.65mm_EP3.4x5mm; MPN TPS26600PWPR

Connections:
3V3_ESP: C6.1, C10.1, C11.1, J2.1, JP2.1 (A), R12.2, TP4.1, U2.5 (VCC), U3.1 (VCCA), U3.5 (DIR), U4.5 (VCC)
+3V3_P: C3.1, C4.1, J5.2, J6.2, JP1.1 (A), R3.1, TP3.1, U1.2 (VO)
+5V_P: C1.1, C2.1, C5.1, C7.1, C8.1, C9.1, J3.1, JP1.3 (B), R2.1, TP2.1, U1.3 (VI), U3.6 (VCCB), U5.15 (OUT), U5.16 (OUT)
EF_DVDT: C13.1, U5.12 (dVdT)
EF_ILIM: R19.1, U5.11 (ILIM)
EF_OVP: R17.2, R18.1, U5.5 (OVP)
EF_RTN: C13.2, R18.2, R19.2, U5.6 (MODE), U5.8 (RTN), U5.17 (RTN)
EF_UVLO: R16.2, R17.1, U5.3 (UVLO)
GND: C1.2, C2.2, C3.2, C4.2, C5.2, C6.2, C7.2, C8.2, C9.2, C10.2, C11.2, C12.2, J1.2, J2.2, J2.11, J2.12, J3.4, J4.1, J5.1, J6.1, LED1.1 (K), LED2.1 (K), R4.2, R5.2, R7.2, TP5.1, TP6.1, U1.1 (GND), U2.3 (GND), U3.2 (GND), U4.3 (GND), U5.9 (GND)
GP_IO1: J6.3, R13.1
GP_IO1_ESP: J2.9, R13.2
GP_IO2: J6.4, R14.1
GP_IO2_ESP: J2.10, R14.2
I2C_PU: JP2.2 (B), R8.1, R9.1
I2C_SCL: J2.6, J5.4, R9.2
I2C_SDA: J2.5, J5.3, R8.2
LED1_A: LED1.2 (A), R2.2
LED2_A: LED2.2 (A), R3.2
UART_RX: J4.4, R11.1
UART_RX_ESP: J2.8, U4.4
UART_RX_IN: R11.2, R12.1, U4.2
UART_TX: J4.3, R10.2
UART_TX_ESP: J2.7, R10.1
UART_VCC: J4.2, JP1.2 (C)
US_ECHO_5V: J3.3, R6.1
US_ECHO_ESP: J2.4, TP7.1, U2.4
US_ECHO_IN: R6.2, R7.1, U2.2
US_TRIG_5V: J3.2, R5.1, R15.2, TP8.1
US_TRIG_B: R15.1, U3.4 (B)
US_TRIG_ESP: J2.3, R4.1, U3.3 (A)
VIN_RAW: C12.1, J1.1, R16.1, TP1.1, U5.1 (IN), U5.2 (IN)

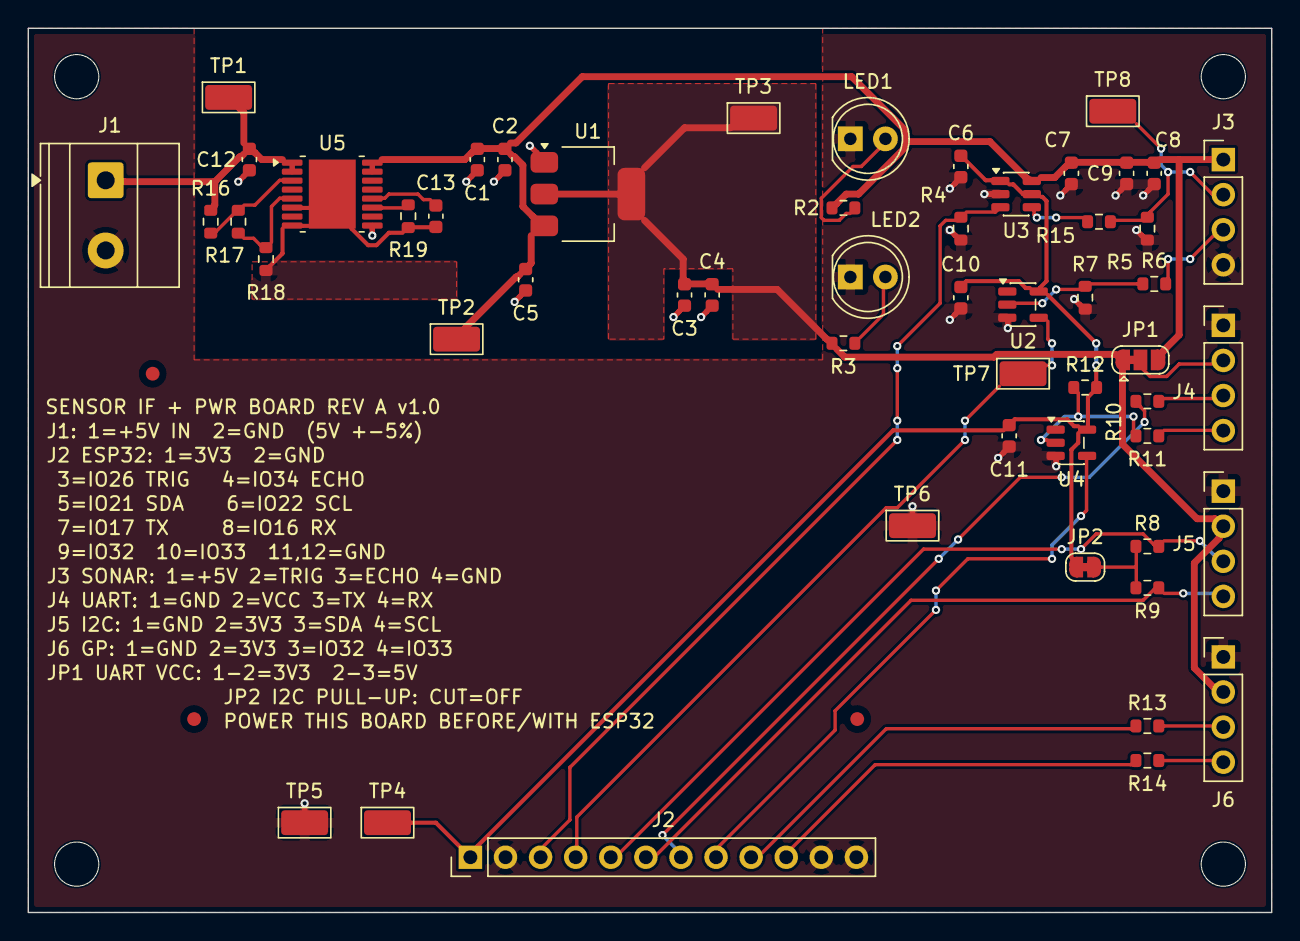
[picture p44: board Sensor_Interface_Power_Board.kicad_pcb from above]

Board: 2 copper layers, 90.0 x 64.0 mm, 61 parts (0 on the bottom side), 31 nets.
