AJC938/AI-PCB-Engineer/reports/v0.0.3/evidence/kicad/fp_test.kicad_pcb

## KiCad design reports/v0.0.3/evidence/kicad/fp_test.kicad_pcb (2026-11-08, an earlier design)

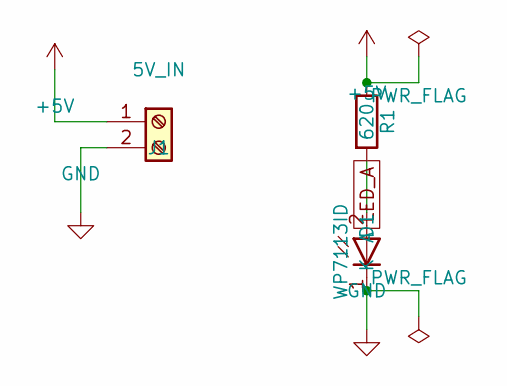
[picture p45: schematic fp_test.kicad_sch]

Parts:
D1: WP7113ID; LED_D5.0mm_WP7113ID; MPN WP7113ID
J1: 5V_IN; TerminalBlock_Phoenix_MKDS-1,5-2-5.08_1x02_P5.08mm_Horizont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; MPN 1715721
R1: 620; R_Axial_DIN0207_L6.3mm_D2.5mm_P10.16mm_Horizontal; MPN MFR-25FBF52-620R

Connections:
+5V: J1.1, R1.1
GND: D1.1 (K), J1.2
LED_A: D1.2 (A), R1.2

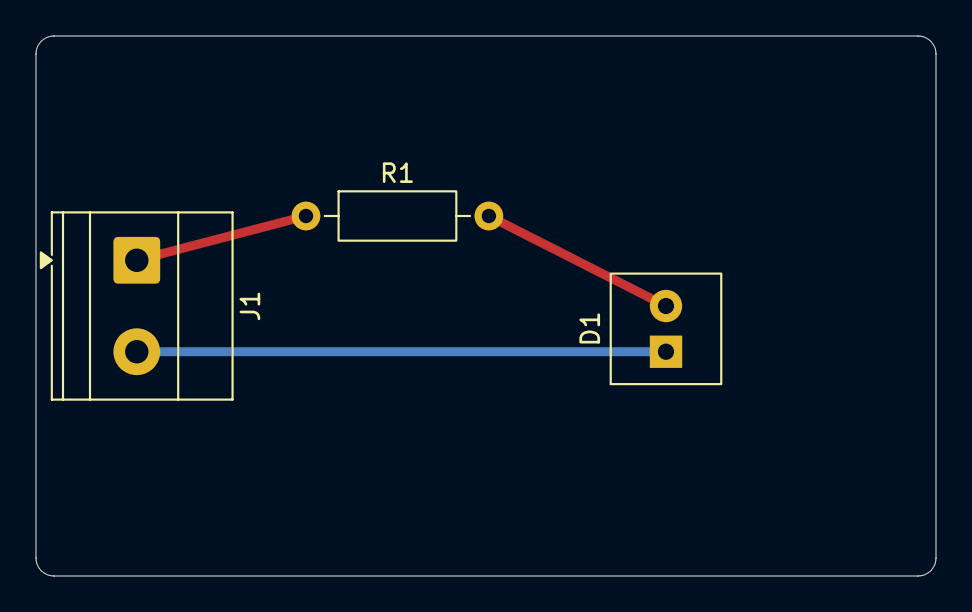
[picture p46: board fp_test.kicad_pcb from above]

Board: 2 copper layers, 50.0 x 30.0 mm, 3 parts (0 on the bottom side), 3 nets.
