AJC938/AI-PCB-Engineer/(commit log)

2026-11-07 chore: V0.0.1 environment setup and MCP integration baseline
    - Workspace structure, CLAUDE.md, engineering rules, agent instructions,
    architecture, roadmap, scope, environment and dependency reports
    - Sanitized MCP template (.mcp.example.json); local .mcp.json gitignored
    - Sandbox smoke-test evidence (MCP tool calls, kicad-cli DRC/ERC)
2026-11-07 v0.0.2: calculations, datasheet index, footprint-field sync workaround
2026-11-07 v0.0.2: MCP capability evaluation on complete LED test board
    - LED indicator test board: schematic, ERC, netlist, PCB, routing, GND zone,
    Gerber/drill/BOM/CPL/PDF exports, all via KiCAD-MCP-Server v2.8.3 (SWIG)
    - Independent verification with kicad-cli: ERC 0, DRC 0, unconnected 0,
    schematic parity 0
    - Ten evaluation reports + capability matrix + sanitized evidence
    - MCP workflow rules and two helper scripts (field sync, fab inspection)
    Digital validation only; no hardware fabricated or tested.
    [led_test-B_Cu.gbl, led_test-B_Mask.gbs, led_test-B_Silkscreen.gbo, led_test-Edge_Cuts.gm1, led_test-F_Cu.gtl, led_test-F_Mask.gts, led_test-F_Silkscreen.gto, led_test-NPTH.drl]
2026-11-08 v0.0.3-rc1: MCP advanced capability evaluation (IPC, custom parts, GUI driver)
    - SWIG baseline 12/12 PASS; identical suite on IPC: connects/saves but
    footprint reads fail silently (kicad-python 0.8.0 vs KiCad 10.0.8)
    - Custom symbol creation verified end-to-end with native MCP tools
    - Custom footprint creation verified (rectangle-only graphics, no type attr)
    - GUI driver not usable on Windows (install path, unprocessed clicks,
    screenshot privacy); GUI DRC blocked on active desktop
    - Reproducible harness, test generators, sanitized evidence, 10 reports
    - New workflow rules 10-14; defects D-10..D-22 documented
    - KiCad global config restored byte-identical after approved temporary changes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
    [fp_test.kicad_pcb, fp_test.kicad_sch, ipc_after_suite.kicad_pcb, swig_after_suite.kicad_pcb, sym_test.kicad_sch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]
2026-11-08 v0.1.0 phase 1: requirements and design planning (no schematic/PCB)
    Sensor Interface & Power Management Board for ESP32:
    - design brief, 52 requirements, block diagrams, interface spec
    - power budget for two architectures, back-feed analysis
    - risk register (22), component selection plan (no MPNs)
    - verification plan with acceptance criteria, 18 open questions
    - reproducible planning calculations with evidence tags
    - reference index (Espressif, NXP official; HC-SR04 secondary only)
    Not ready for design freeze: 13 blocking open questions.
2026-11-08 v0.1.0: engineering design, component selection and complete schematic
    - Architecture B (DevKit on own USB; board powers peripherals only)
    - Variant-independent ultrasonic interface (LVC1T45 TRIG, LVC1G17 ECHO/RX)
    - Calculations + independent Monte Carlo checks (10/10 PASS)
    - DS-01..DS-16 datasheet index, 48 BOM parts with MPNs
    - KiCad schematic built via KiCAD-MCP-Server (SWIG): ERC 0 (MCP and
    kicad-cli, no exclusions), netlist verified against the design table
    - 13 reports in reports/v0.1.0 with sanitized evidence
    - Phase 1: OQ status pointer, risks R-30..R-35; changelog entry
    Not physically tested. Not production-ready. No tag, no push.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
    [Sensor_Interface_Power_Board.kicad_pcb, Sensor_Interface_Power_Board.kicad_sch, bom_cli.csv]
2026-11-09 v0.2.0: record KiCad-GUI-normalized project settings (no design change)
    Opening the project in the KiCad 10 GUI wrote default board/ERC settings
    into the .kicad_pro. No exclusions; schematic and board unchanged.
2026-11-09 v0.2.0 gate A: eFuse power entry revision and schematic rebuild
    - TVS/LDO analysis: SMAJ6.0A clamp (>= 6.67 V) cannot protect the TLV1117LV
    (6 V abs max); F1/Q1/R1/D1 replaced by TI TPS26600 eFuse (OVP 5.39-5.82 V
    worst case, reverse polarity -60 V, 0.6 A current limit, inrush control)
    - R15 1k series resistor on TRIG (ESD/mis-wiring current limit)
    - Project-local footprint for TI PWP0016A land pattern (SLVSDG2G p.53/54)
    - calculations/v0.2.0: design calcs + independent Monte Carlo (PASS)
    - Schematic rebuilt via MCP (364/364 calls ok); ERC 0 (MCP and kicad-cli,
    all severities); netlist verifier PASS (31 nets, 54 footprints, 52 MPNs)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
    [Sensor_Interface_Power_Board.kicad_pcb, Sensor_Interface_Power_Board.kicad_sch]
2026-11-09 v0.2.0: add mounting holes/fiducials to schematic; PCB build script (pre-layout checkpoint)
    [Sensor_Interface_Power_Board.kicad_sch]
2026-11-09 v0.2.0: complete PCB layout (placement, routing, zones, silkscreen)
    - 90 x 64 mm, 2 layers, all parts top side; 4x M3 holes, 3 fiducials
    - Placement from build/build_pcb.py (legality-checked), written via MCP
    - Routing computed by build/route_pcb.py (A* grid router), written via
    MCP route_trace/add_via (331 segments, 57 vias); zones via
    add_copper_pour (add_zone unsupported in SWIG: D-23)
    - Workarounds: field sync (D-3), NC pad nets (D-24), schematic BOM flags
    for H/FID/JP, solid +3V3_P thermal-zone connection (251 mm2)
    - kicad-cli DRC --severity-all --schematic-parity (stored and refilled
    zones): 0 violations, 0 unconnected, 0 parity issues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
    [Sensor_Interface_Power_Board.kicad_pcb, Sensor_Interface_Power_Board.kicad_sch]
2026-11-09 v0.2.0: manufacturing package and validation evidence
    - manufacturing/v0.2.0: Gerber X2 (rev 0.2.0), Excellon PTH/NPTH + maps,
    IPC-D-356, CPL (aux origin = board bottom-left), BOM (33 lines, 52
    placements, SMT/THT/side/no-substitution), assembly drawings, layer
    plots, schematic PDF, STEP
    - Independent audit (build/audit_fab_outputs.py): 11/11 PASS
    - Evidence: ERC/DRC reports (0/0/0), netlist verifier PASS, sanitized MCP
    run logs, router outputs, 3D renders and drawing previews
    - PCB title block (rev 0.2.0) and aux origin set (MCP set_board_origin)
    [Sensor_Interface_Power_Board-B_Cu.gbl, Sensor_Interface_Power_Board-B_Mask.gbs, Sensor_Interface_Power_Board-B_Paste.gbp, Sensor_Interface_Power_Board-B_Silkscreen.gbo, Sensor_Interface_Power_Board-Edge_Cuts.gm1, Sensor_Interface_Power_Board-F_Cu.gtl, Sensor_Interface_Power_Board-F_Mask.gts, Sensor_Interface_Power_Board-F_Paste.gtp]
2026-11-09 v0.2.0: reports, DFM profiles, datasheet addendum, risks and MCP rules
    - reports/v0.2.0: 20 reports (Gate A electrical/TVS-LDO/thermal, Gate B
    manufacturer comparison + recommendation + BOM sourcing, Gate C
    footprints, placement, routing, DFM, DFA, ERC, DRC, files/assembly
    audits, 3D review, open questions, evidence index, completion summary,
    final report)
    - manufacturing/v0.2.0: README, fabrication/assembly notes, generic DFM
    profile (applied), PCBWay provisional and NextPCB alternate profiles
    - datasheets/v0.2.0: DS-17..DS-20 and addenda
    - Risk register R-36..R-41 (R-32 closed by design); AI agent rules 15-20
    (MCP defects D-23, D-24 and workarounds); changelog
    - Reopen check in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
2026-11-09 v0.3.0: board revision label Rev A (DDR-22), no electrical change
    Title block rev 0.2.0 -> A in schematic and PCB, comment 3 "Release v1.0.0 (Rev A)
    - fabrication-ready design, NOT physically tested", top silkscreen label
    "REV A v1.0". Applied by scripts/release/set_release_revision.py (exact-match
    edits with expected counts; refuses to run while an editor lock exists).
    Netlist, copper, drills, BOM and CPL unchanged. ERC 0, DRC 0/0/0 with parity.
    [Sensor_Interface_Power_Board.kicad_pcb, Sensor_Interface_Power_Board.kicad_sch]
2026-11-09 v0.3.0: final engineering audit and regenerated Rev A manufacturing package
    - Final engineering audit (TPS26600 pin review, reverse-polarity path tracing,
    LDO thermal re-derivation, signals, connectors, footprints, portability).
    - scripts/release: kicad-cli build, 19-check package audit, BOM enrichment,
    deterministic ZIP packaging with extraction tests, path sanitizer.
    - manufacturing/Sensor_Interface_Power_Board/RevA: Gerber X2, Excellon,
    IPC-D-356, BOM, CPL, drawings, STEP, three tested ZIPs, SHA256SUMS;
    reviewed manufacturer profiles (none confirmed).
    - KiCad-generated renders, validation and MCP reopen evidence, calculations,
    risk register R-36/37 updates and R-42..44, agent ru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
    [Sensor_Interface_Power_Board-B_Cu.gbl, Sensor_Interface_Power_Board-B_Mask.gbs, Sensor_Interface_Power_Board-B_Paste.gbp, Sensor_Interface_Power_Board-B_Silkscreen.gbo, Sensor_Interface_Power_Board-Edge_Cuts.gm1, Sensor_Interface_Power_Board-F_Cu.gtl, Sensor_Interface_Power_Board-F_Mask.gts, Sensor_Interface_Power_Board-F_Paste.gtp]
2026-11-09 v1.0.0: README, documentation, licences and release notes
    Hardware README, docs tree (quick start, architecture, electrical design,
    connection guide, layout, manufacturing, assembly, safety, validation status,
    visual review, licensing, AI workflow), LICENSE-HARDWARE (CERN-OHL-S-2.0,
    SPDX text), LICENSE-CODE (MIT), CONTRIBUTING, datasheet/hardware/manufacturing
    indexes, CHANGELOG 1.0.0, release/v1.0.0 notes and checklist.
    Status: DIGITALLY VALIDATED DESIGN - NOT PHYSICALLY FABRICATED OR TESTED.
    Licence variant awaits owner confirmation before the stable v1.0.0 tag.
2026-11-09 v1.0.0: final licensing (CERN-OHL-P-2.0 hardware, MIT code) and release audit
    - LICENSE-HARDWARE: official CERN-OHL-P-2.0 text from OHWR, byte-identical;
    LICENSE-CODE: OSI MIT text, copyright "AI-PCB-Engineer contributors"
    (owner-approved attribution). LICENSES/ copies for REUSE tooling.
    - LICENSE_SCOPE.md + REUSE.toml: file/directory scope map (404 files: 349
    CERN-OHL-P-2.0, 54 MIT, 1 third-party), mixed-document treatment, decision
    record for code that generates the hardware (CERN-OHL-P section 3.4).
    - THIRD_PARTY_NOTICES.md: U5 project footprint is derived from a KiCad library
    footprint and stays CC-BY-SA-4.0 WITH KiCad-libraries-exception; KiCad data
    in design/generated files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
2026-11-09 docs: clarify peripheral rail diagram
